NuwanUdara/Digital-Alarm-Clock/Full Product/Report/readme.txt

This is the final project report for our project and written using latex. Overleaf editor was used and the project link is 
https://www.overleaf.com/read/dtgxvjcbbptn
