NuwanUdara/Digital-Alarm-Clock/Microproducts/Audio Ouput/PCB/Read Me.txt

https://oshwlab.com/nuwanudara36/audio-output

PCB done in easyEDA online tool and active project link is provided above. There are 3 pcb files currently.
1. Single layer with 3 jumper connections marked as bottom layer
2. Fully single layer Pcb with low route width
3. Full 2 layer pcb
4. Fully Single layer PCB with Good routings

The altium files are not working properly please use eazyEDA
