NuwanUdara/Digital-Alarm-Clock/Full Product/Report/src/LCD Images/LCD 16.jpg

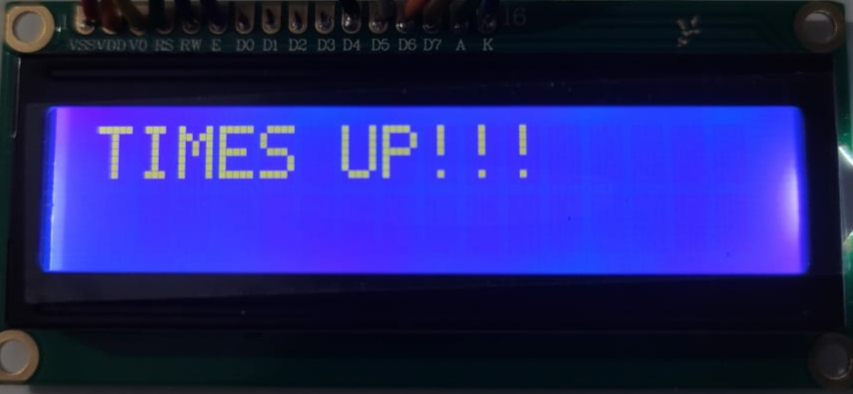
Full Product/Report/src/LCD Images/LCD 16.jpg
