NuwanUdara/Digital-Alarm-Clock/Microproducts/Audio Ouput/PCB/PCB_PCB_Audio Output.png

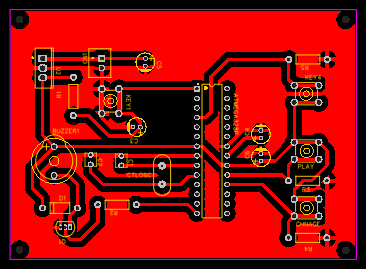
Microproducts/Audio Ouput/PCB/PCB_PCB_Audio Output.png
