NuwanUdara/Digital-Alarm-Clock/Microproducts/Menu Display/Evaluation 2/PCB develop/schemtic/Schematic_Menu-display.png

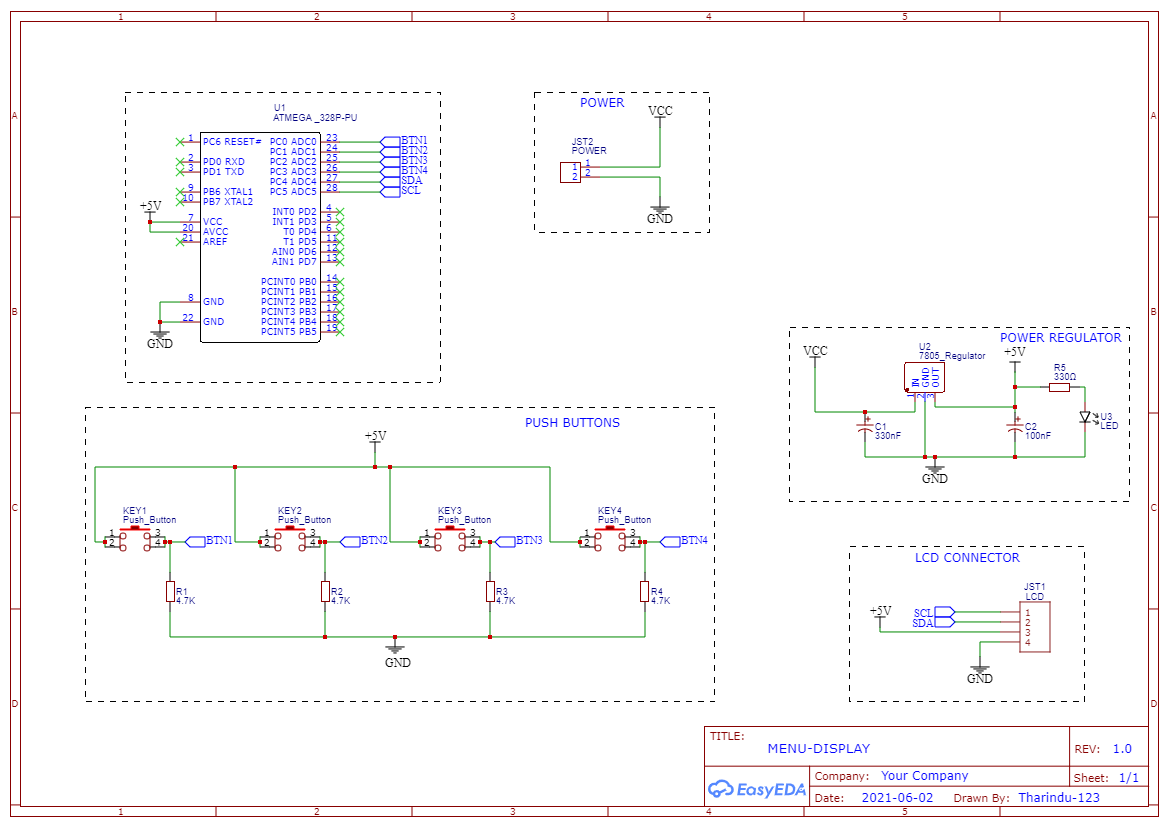
Microproducts/Menu Display/Evaluation 2/PCB develop/schemtic/Schematic_Menu-display.png
