NuwanUdara/Digital-Alarm-Clock/Microproducts/Audio Ouput/Enclosure/Assem6.SLDASM

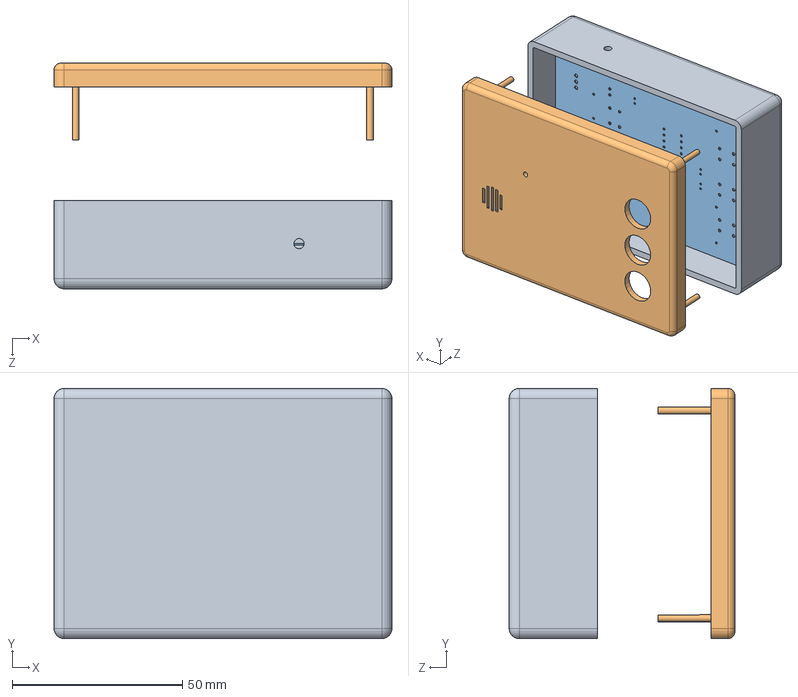
[picture p39: CAD file, 2021-06-05]
Microproducts/Audio Ouput/Enclosure/Assem6.SLDASM
99.2 x 73.4 x 66.3 mm
Part7^PCB_Audio Output.step
Part8^PCB_Audio Output.step. v1SLDPRT
