NuwanUdara/Digital-Alarm-Clock/Microproducts/Menu Display/Evaluation 2/Enclosure/full product.SLDASM

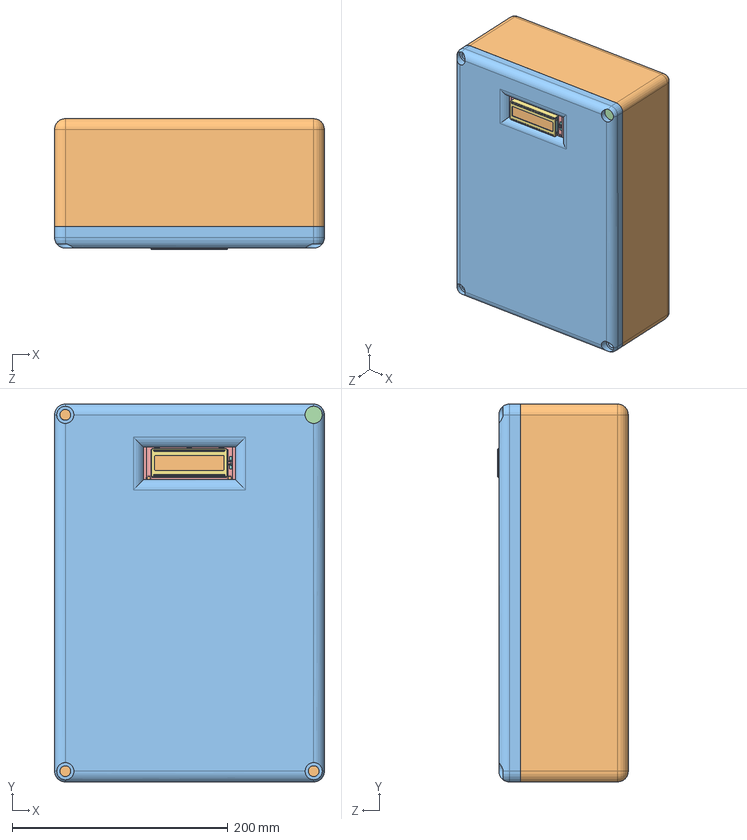
[picture p40: CAD file, 2021-08-10]
Microproducts/Menu Display/Evaluation 2/Enclosure/full product.SLDASM
250.0 x 350.0 x 121.1 mm
OBJ_PCB_Menu-display
back cover
nut
pcbboard
16pin_header__
lcd window
backlight
conductor x 2
liquid crystal grabcad
smt_resistor222 x 6
smt_resistor101 x 2
