NuwanUdara/Digital-Alarm-Clock/Microproducts/Alarm Timing/Enclosure/Enclosure.SLDASM

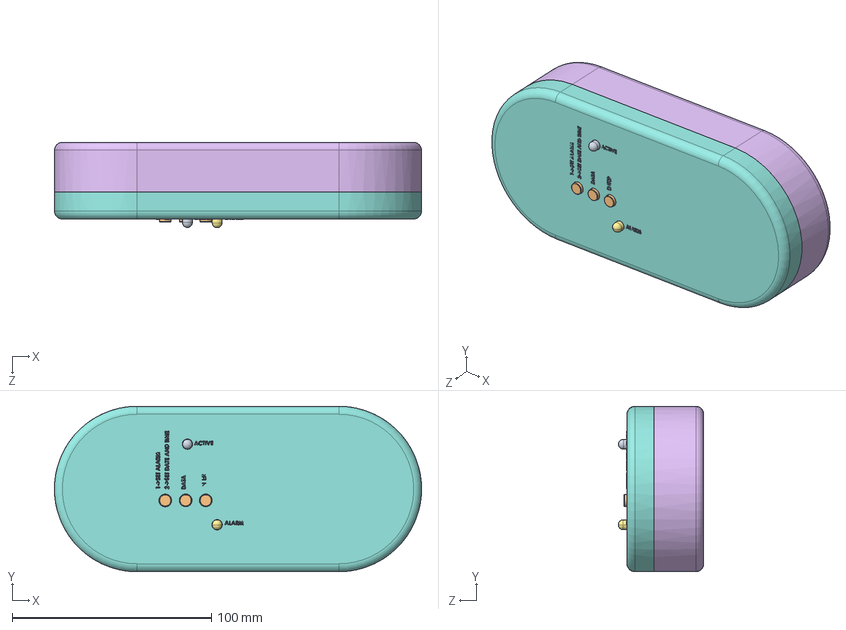
[picture p41: CAD file, 2021-06-02]
Microproducts/Alarm Timing/Enclosure/Enclosure.SLDASM
184.4 x 83.1 x 43.0 mm
Extruded.step
Extruded-0.step x 2
Extruded-1.step x 2
Extruded-2.step x 4
Extruded-3.step x 2
Extruded-4.step x 2
Extruded-5.step x 2
Extruded-6.step x 2
Extruded-7.step x 4
Extruded-8.step x 2
Extruded-9.step x 2
Extruded-10.step x 4
Extruded-11.step x 2
Extruded-12.step x 2
Extruded-13.step
Extruded-14.step
Extruded-15.step x 3
Extruded-16.step x 3
Extruded-17.step
Extruded-18.step
Part1^Enclosure
LED
Part3^Enclosure
Led_Verde
Push Button x 3
