NuwanUdara/Digital-Alarm-Clock/Microproducts/Audio Ouput/Enclosure/Last Build/Assem7.SLDASM

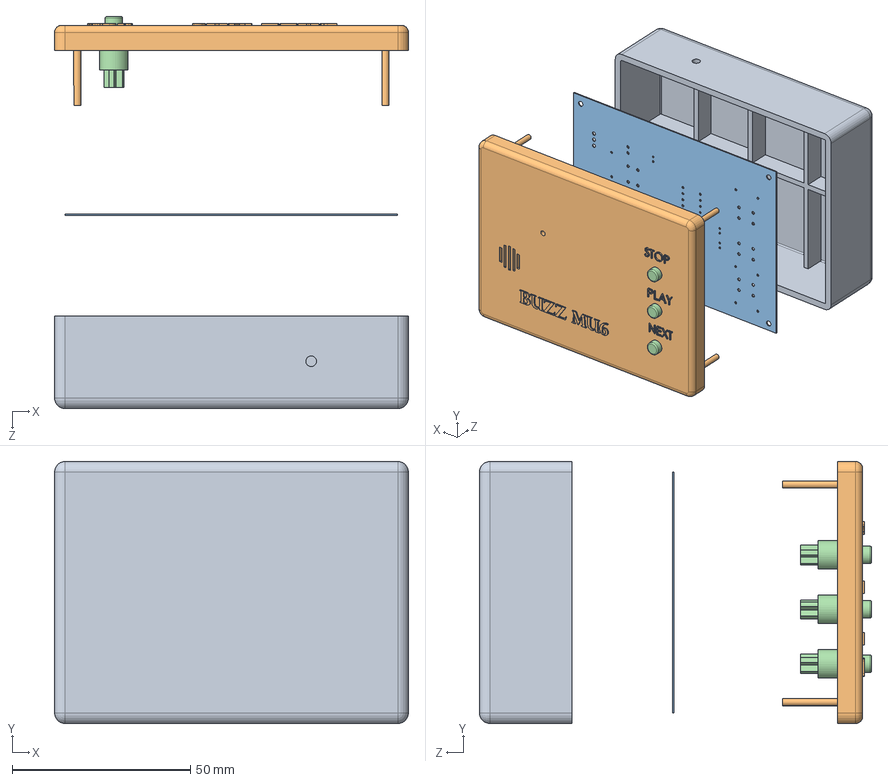
[picture p42: CAD file, 2021-06-07]
Microproducts/Audio Ouput/Enclosure/Last Build/Assem7.SLDASM
99.2 x 73.4 x 109.9 mm
Part7^PCB_Audio Output.step
Part8^PCB_Audio Output.step. v1SLDPRT
Button x 3
