NuwanUdara/Digital-Alarm-Clock/Microproducts/Audio Ouput/Enclosure/PCB_Audio Output.step.SLDASM

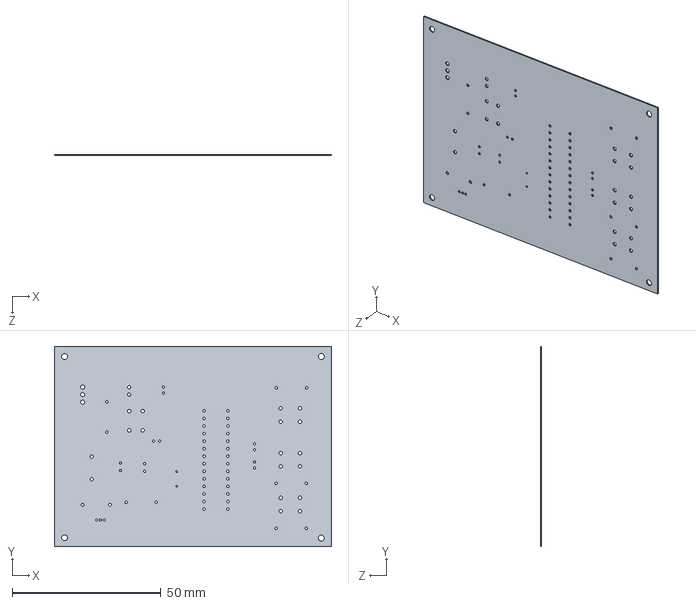
[picture p43: CAD file, 2021-06-05]
Microproducts/Audio Ouput/Enclosure/PCB_Audio Output.step.SLDASM
93.2 x 67.4 x 0.411 mm
