NuwanUdara/Digital-Alarm-Clock/Microproducts/Key Input/Enclosure/led_full.SLDASM

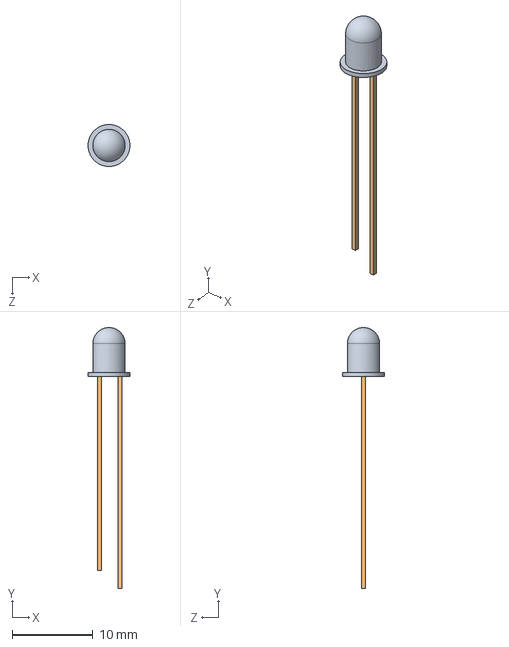
[picture p45: CAD file, 2021-06-04]
Microproducts/Key Input/Enclosure/led_full.SLDASM
5.20 x 32.3 x 5.19 mm
led2
led
