NuwanUdara/Digital-Alarm-Clock/Microproducts/Menu Display/Evaluation 2/Enclosure/parts/LCD.SLDASM

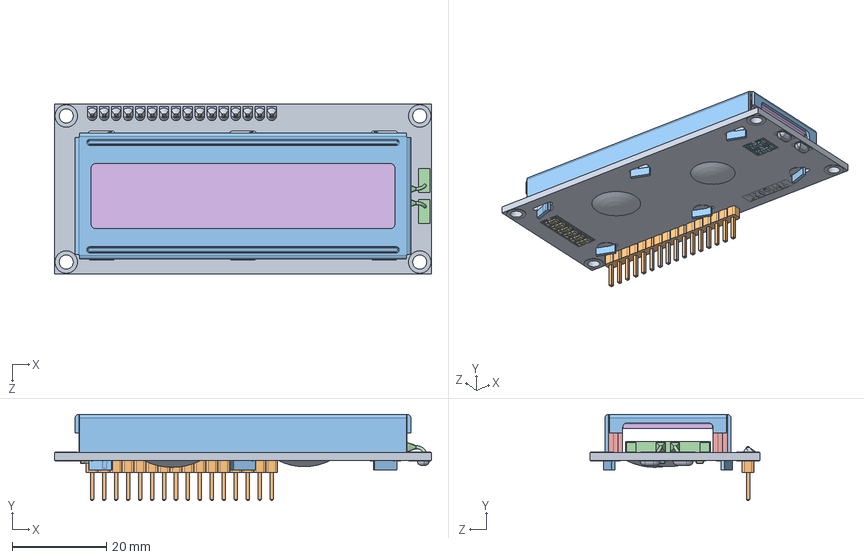
[picture p46: CAD file, 2021-06-05]
Microproducts/Menu Display/Evaluation 2/Enclosure/parts/LCD.SLDASM
80.0 x 18.3 x 36.0 mm
pcbboard
16pin_header__
lcd window
backlight
conductor x 2
liquid crystal grabcad
smt_resistor222 x 6
smt_resistor101 x 2
