NuwanUdara/Digital-Alarm-Clock/Full Product/Enclosure of final product and components/cct.SLDASM

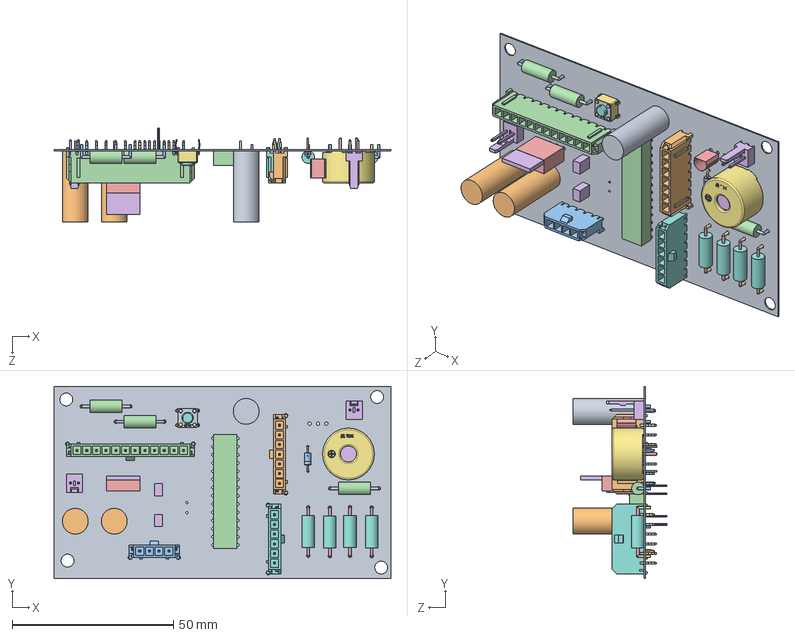
[picture p47: CAD file, 2021-08-11]
Full Product/Enclosure of final product and components/cct.SLDASM
104.4 x 59.6 x 29.0 mm
6620xx11122_PIN.step x 4
66200411122-0.step
Extruded.step
Extruded-1.step
Extruded-2.step
Body.step
button.step
cover.step
leads.step
circle.step
TE_Connectivity.step
Cylinder.step x 4
Sphere.step x 8
Cylinder-3.step x 8
Cylinder-4.step x 4
Cylinder-5.step x 3
Sphere-6.step x 6
Cylinder-7.step x 6
Cylinder-8.step x 3
Extruded-9.step
6620xx11122_PIN-10.step x 6
66200611122-11.step
6620xx11122_PIN-12.step x 7
66200711122-13.step
6620xx11122_PIN-14.step x 12
66201211122-15.step
1.step
2.step
3.step
TDK_Logo.step
1-16.step
2-17.step
3-18.step
4.step
Extruded-19.step x 4
Extruded-20.step x 2
Cylinder-21.step
Cylinder-22.step
Cylinder-23.step
Cylinder-24.step x 2
Cylinder-25.step x 2
Cylinder-26.step x 2
