NuwanUdara/Digital-Alarm-Clock/Full Product/Enclosure of final product and components/E-Stop_Assembled.SLDASM

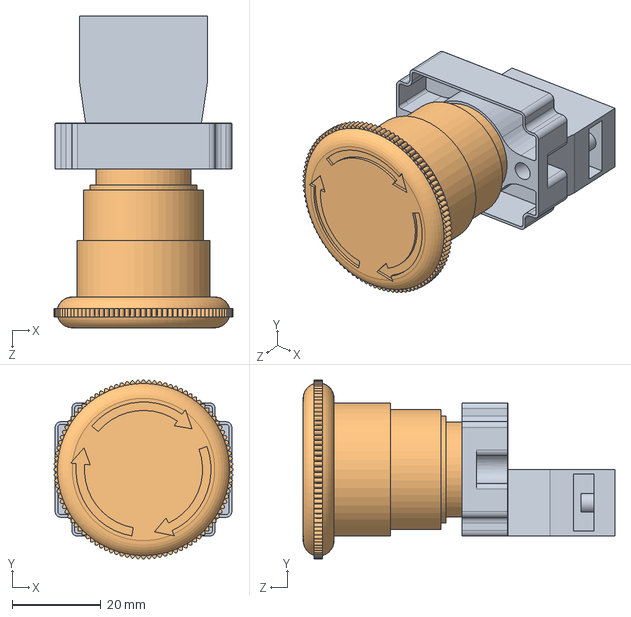
[picture p48: CAD file, 2021-08-10]
Full Product/Enclosure of final product and components/E-Stop_Assembled.SLDASM
40.4 x 40.4 x 70.4 mm
E-Stop Base^E-Stop_Assembled.stp
E-Stop Button^E-Stop_Assembled.stp
