NuwanUdara/Digital-Alarm-Clock/Full Product/Enclosure of final product and components/Battery.SLDPRT

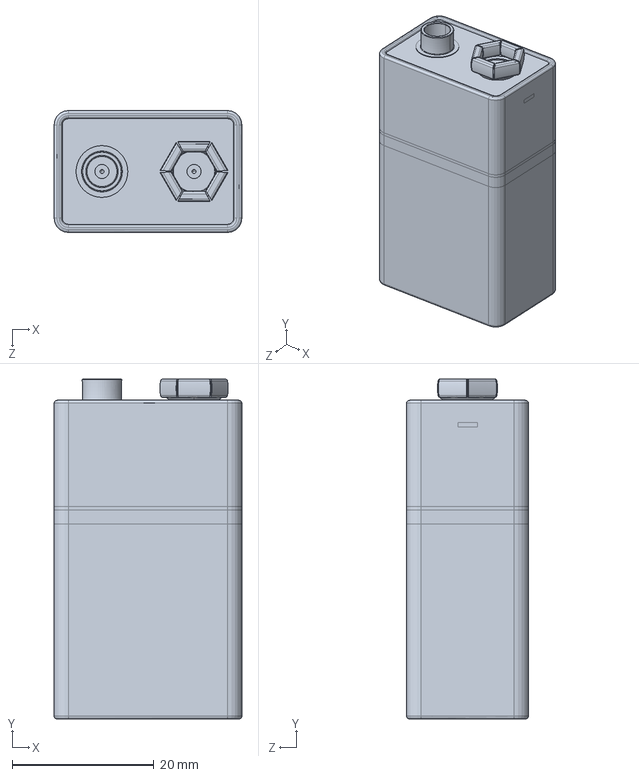
[picture p49: CAD file, 2021-08-11]
Full Product/Enclosure of final product and components/Battery.SLDPRT
26.5 x 48.0 x 17.2 mm
