NuwanUdara/Digital-Alarm-Clock/Microproducts/Alarm Timing/Enclosure/PCB.step

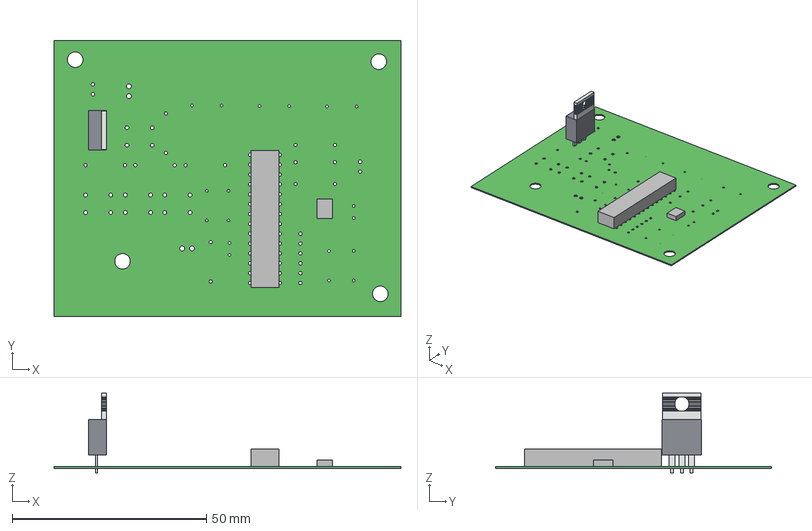
[picture p50: CAD file, 2021-06-02]
Microproducts/Alarm Timing/Enclosure/PCB.step
89.4 x 71.1 x 20.5 mm
Extruded x 43
