NuwanUdara/Digital-Alarm-Clock/Microproducts/Audio Ouput/Enclosure/Last Build/Button.SLDPRT

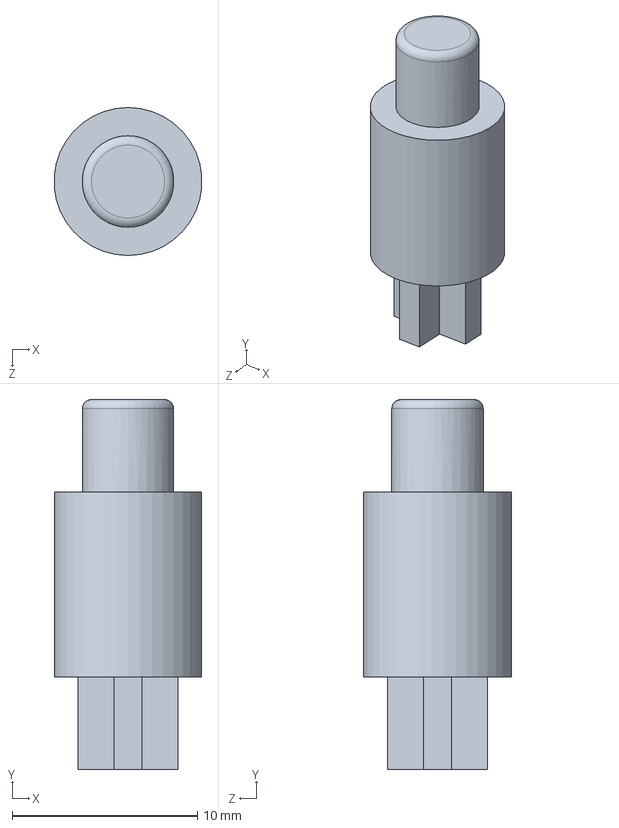
[picture p51: CAD file, 2021-06-07]
Microproducts/Audio Ouput/Enclosure/Last Build/Button.SLDPRT
7.97 x 20.0 x 8.00 mm
