NuwanUdara/Digital-Alarm-Clock/Microproducts/Key Input/Enclosure/keypad.SLDPRT

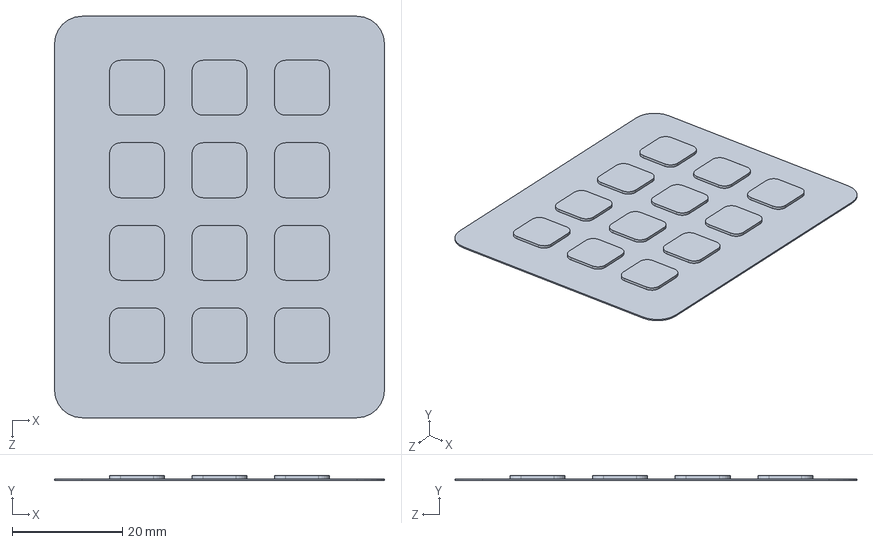
[picture p52: CAD file, 2021-06-04]
Microproducts/Key Input/Enclosure/keypad.SLDPRT
60.0 x 0.9 x 73.0 mm
