NuwanUdara/Digital-Alarm-Clock/Microproducts/Menu Display/Evaluation 2/Enclosure/parts/OBJ_PCB_Menu-display.SLDPRT

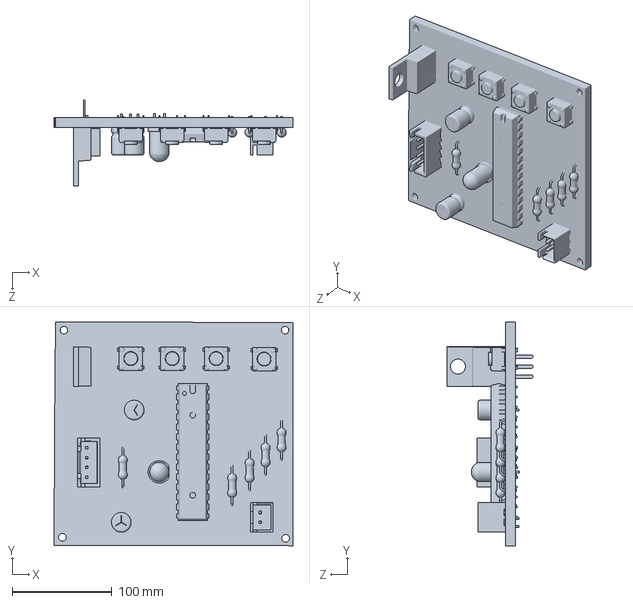
[picture p53: CAD file, 2021-06-05]
Microproducts/Menu Display/Evaluation 2/Enclosure/parts/OBJ_PCB_Menu-display.SLDPRT
239.3 x 223.8 x 86.2 mm
