NuwanUdara/Digital-Alarm-Clock/Full Product/Enclosure of final product and components/KeyPad_3x4_w_pcb.step

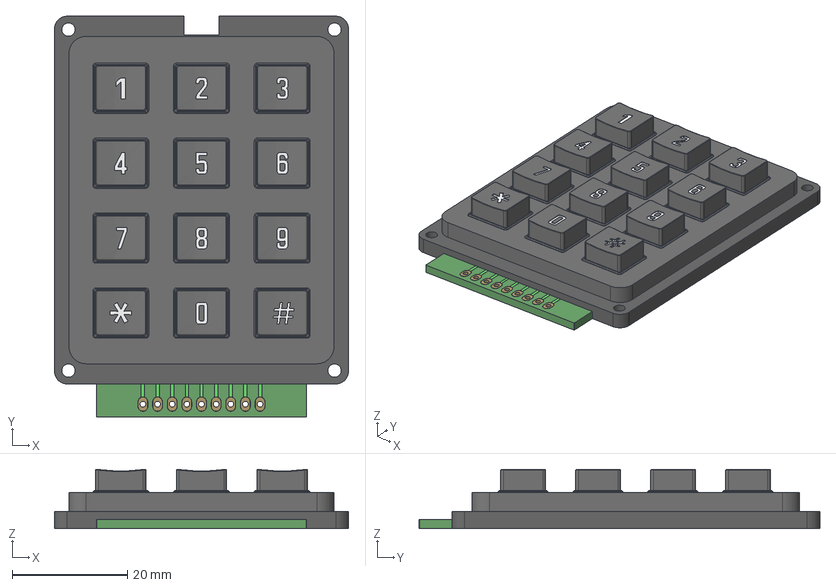
[picture p54: CAD file, 2021-08-11]
Full Product/Enclosure of final product and components/KeyPad_3x4_w_pcb.step
51.0 x 69.5 x 10.3 mm
Body_top
KeyPad
Body_bottom
PCB_pads
PCB
PCBtracks
KeyPad_collor
