NuwanUdara/Digital-Alarm-Clock/Microproducts/Key Input/Enclosure/led2.SLDPRT

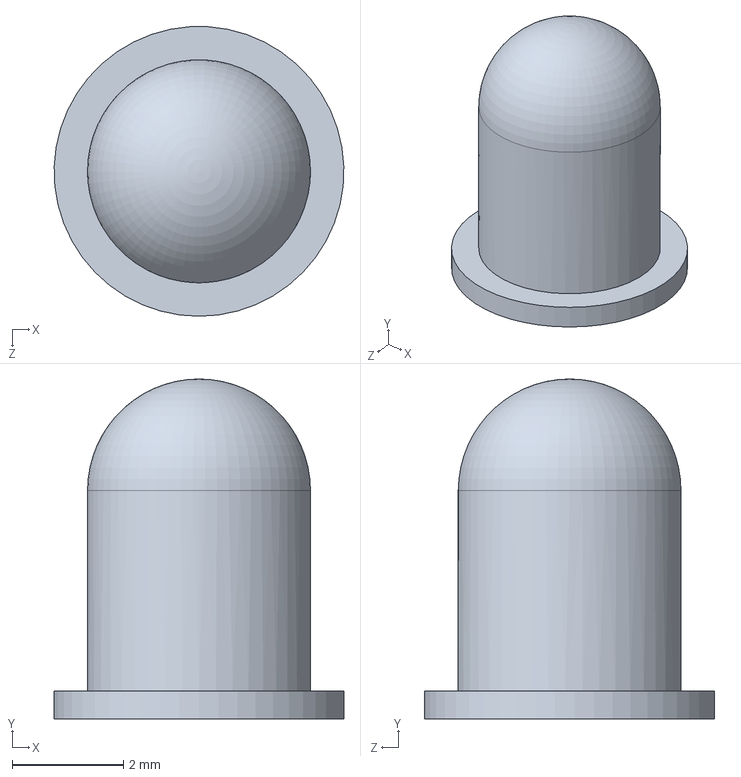
[picture p55: CAD file, 2021-06-04]
Microproducts/Key Input/Enclosure/led2.SLDPRT
5.20 x 6.10 x 5.19 mm
