NuwanUdara/Digital-Alarm-Clock/Microproducts/Menu Display/Evaluation 2/Enclosure/parts/face.SLDPRT

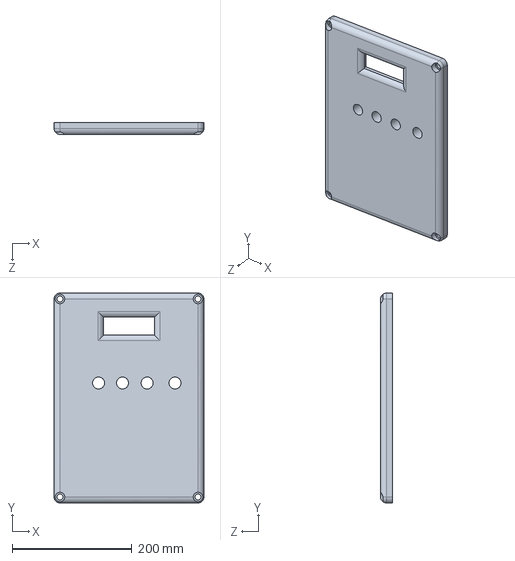
[picture p56: CAD file, 2021-06-05]
Microproducts/Menu Display/Evaluation 2/Enclosure/parts/face.SLDPRT
250.0 x 350.0 x 20.0 mm
