NuwanUdara/Digital-Alarm-Clock/Microproducts/Alarm Timing/Enclosure/Led_Verde.SLDPRT

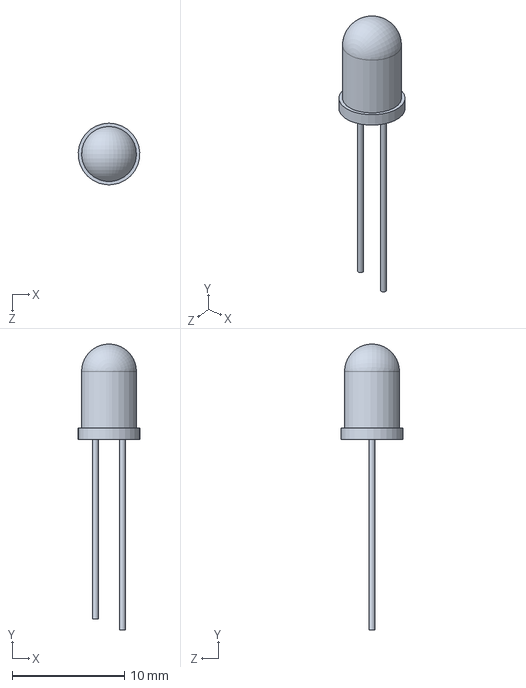
[picture p57: CAD file, 2021-06-02]
Microproducts/Alarm Timing/Enclosure/Led_Verde.SLDPRT
5.49 x 25.5 x 5.50 mm
