NuwanUdara/Digital-Alarm-Clock/Microproducts/Key Input/Enclosure/Key_Input.step

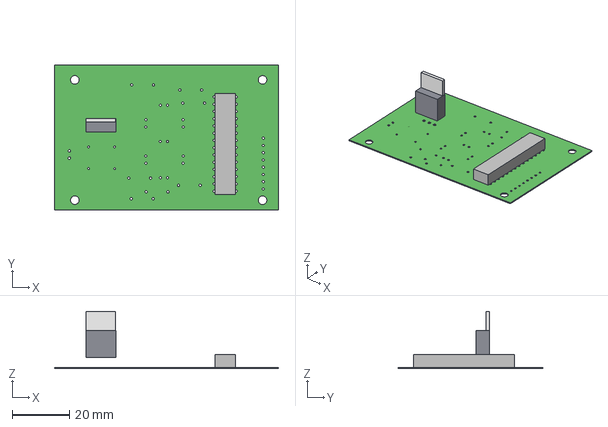
[picture p58: CAD file, 2021-06-04]
Microproducts/Key Input/Enclosure/Key_Input.step
78.5 x 50.8 x 20.1 mm
Extruded x 3
