NuwanUdara/Digital-Alarm-Clock/Microproducts/Menu Display/Evaluation 2/Enclosure/parts/back cover.SLDPRT

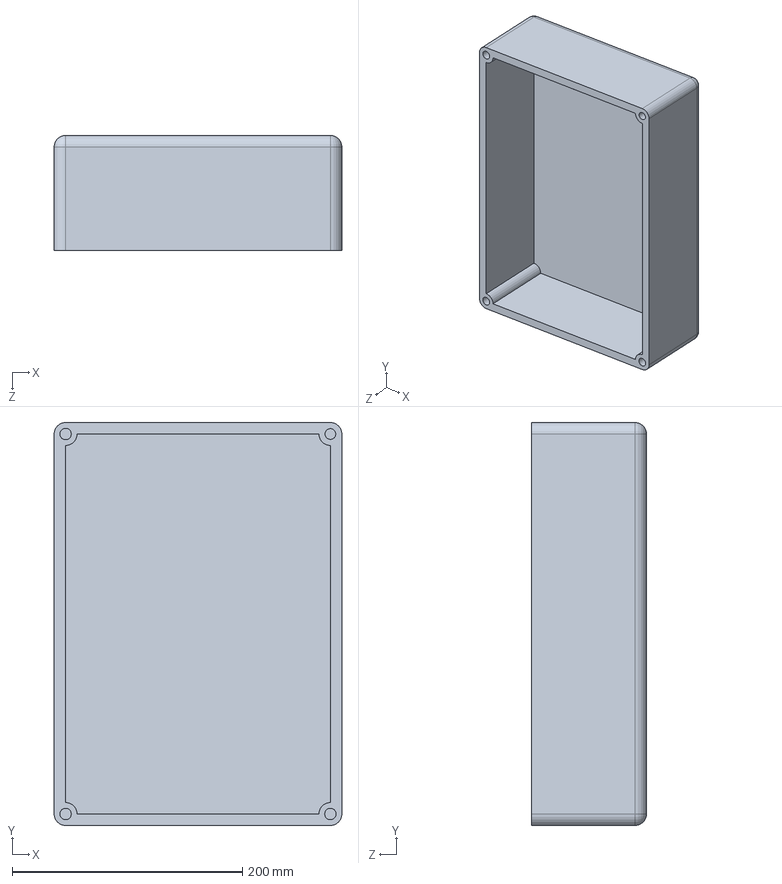
[picture p59: CAD file, 2021-06-05]
Microproducts/Menu Display/Evaluation 2/Enclosure/parts/back cover.SLDPRT
250.0 x 350.0 x 100.0 mm
