NuwanUdara/Digital-Alarm-Clock/Full Product/Enclosure of final product and components/smt_resistor101.sldprt

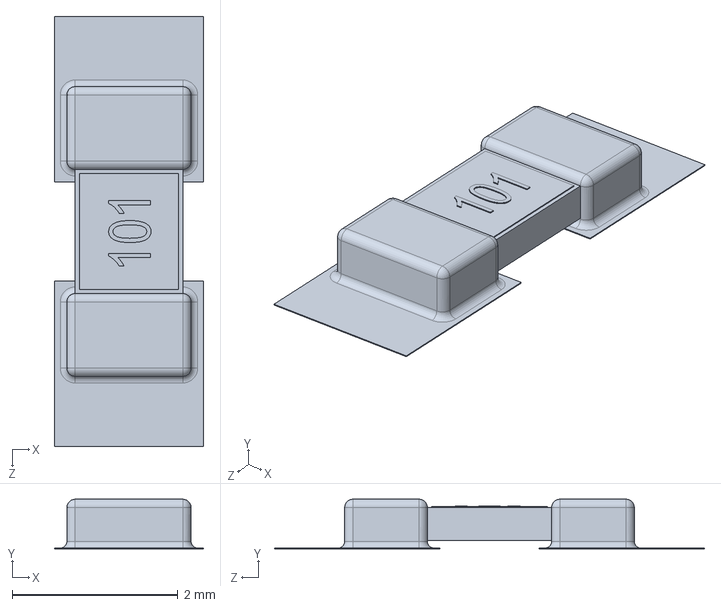
[picture p60: CAD file, 2021-08-11]
Full Product/Enclosure of final product and components/smt_resistor101.sldprt
1.80 x 0.6 x 5.20 mm
