NuwanUdara/Digital-Alarm-Clock/Microproducts/Alarm Timing/Enclosure/Push Button.SLDPRT

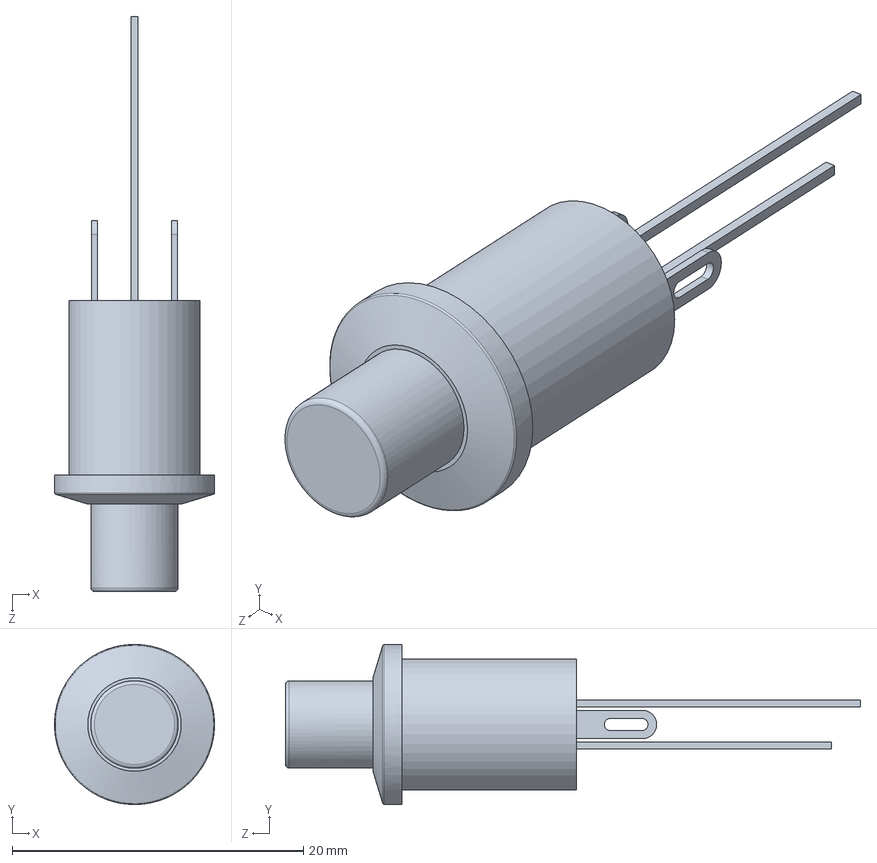
[picture p61: CAD file, 2021-06-02]
Microproducts/Alarm Timing/Enclosure/Push Button.SLDPRT
11.0 x 11.0 x 39.5 mm
