NuwanUdara/Digital-Alarm-Clock/Full Product/Enclosure of final product and components/pcbboard.SLDPRT

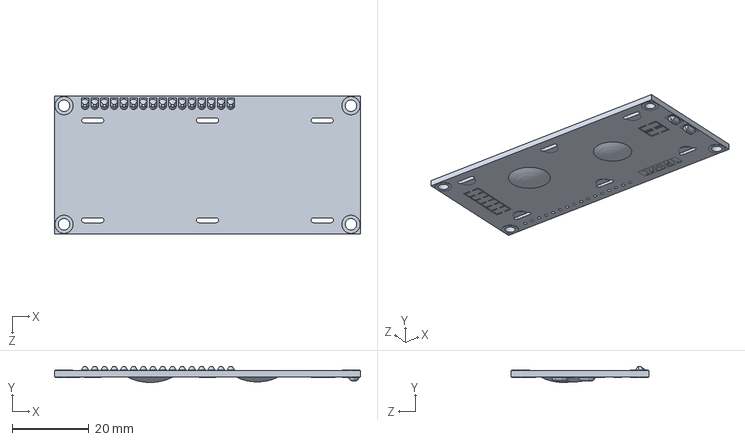
[picture p62: CAD file, 2021-08-11]
Full Product/Enclosure of final product and components/pcbboard.SLDPRT
80.0 x 4.19 x 36.0 mm
