NuwanUdara/Digital-Alarm-Clock/Microproducts/Alarm Timing/Enclosure/LED.SLDPRT

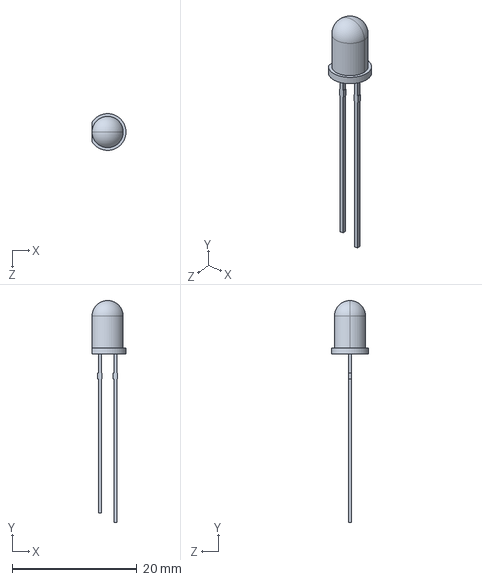
[picture p63: CAD file, 2021-06-02]
Microproducts/Alarm Timing/Enclosure/LED.SLDPRT
5.44 x 35.6 x 5.90 mm
