NuwanUdara/Digital-Alarm-Clock/Microproducts/Key Input/Enclosure/led.SLDPRT

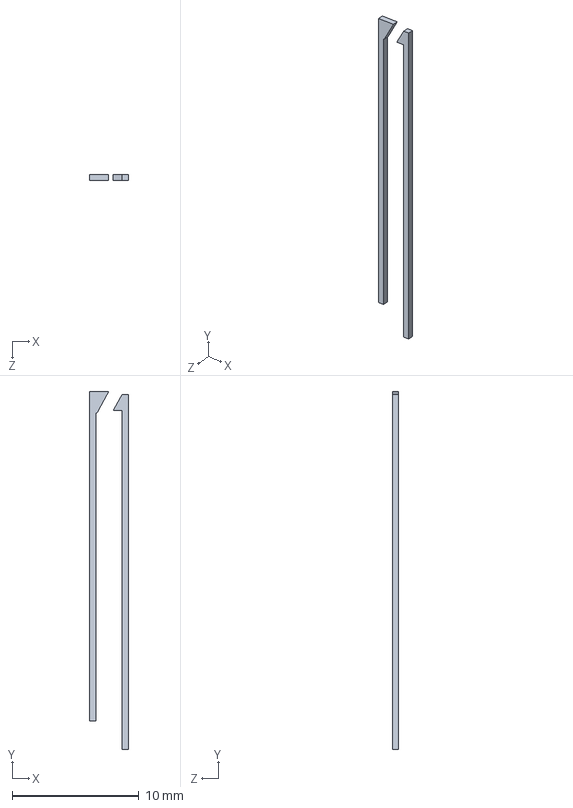
[picture p64: CAD file, 2021-06-04]
Microproducts/Key Input/Enclosure/led.SLDPRT
3.04 x 28.3 x 0.5 mm
