NuwanUdara/Digital-Alarm-Clock/Full Product/Enclosure of final product and components/9V Battery Holder.SLDPRT

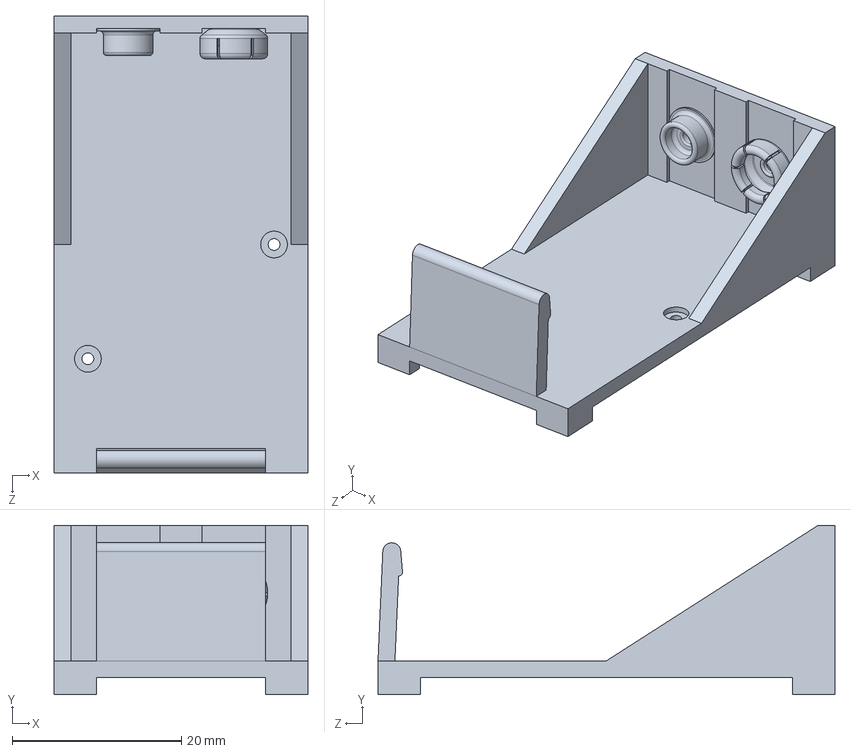
[picture p65: CAD file, 2021-08-11]
Full Product/Enclosure of final product and components/9V Battery Holder.SLDPRT
30.0 x 20.0 x 54.0 mm
