NuwanUdara/Digital-Alarm-Clock/Microproducts/Audio Ouput/Enclosure/Last Build/Part7^PCB_Audio Output.step.SLDPRT

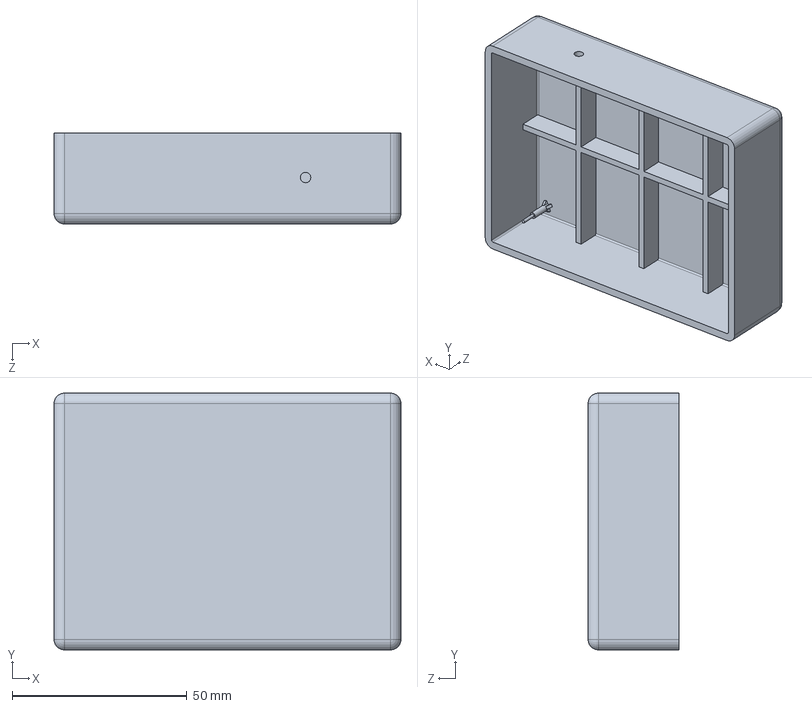
[picture p66: CAD file, 2021-06-05]
Microproducts/Audio Ouput/Enclosure/Last Build/Part7^PCB_Audio Output.step.SLDPRT
99.2 x 73.4 x 26.0 mm
