NuwanUdara/Digital-Alarm-Clock/Microproducts/Key Input/Enclosure/switch.SLDPRT

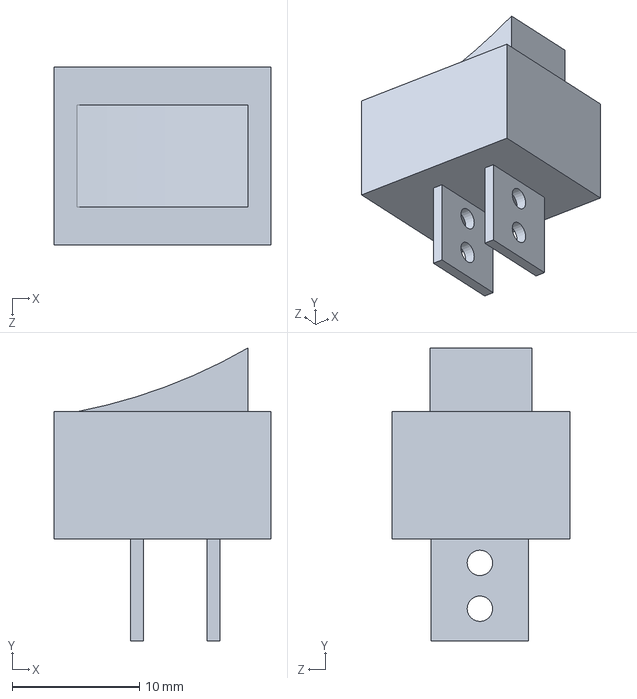
[picture p67: CAD file, 2021-06-04]
Microproducts/Key Input/Enclosure/switch.SLDPRT
17.0 x 23.0 x 14.0 mm
