NuwanUdara/Digital-Alarm-Clock/Full Product/Enclosure of final product and components/body.SLDPRT

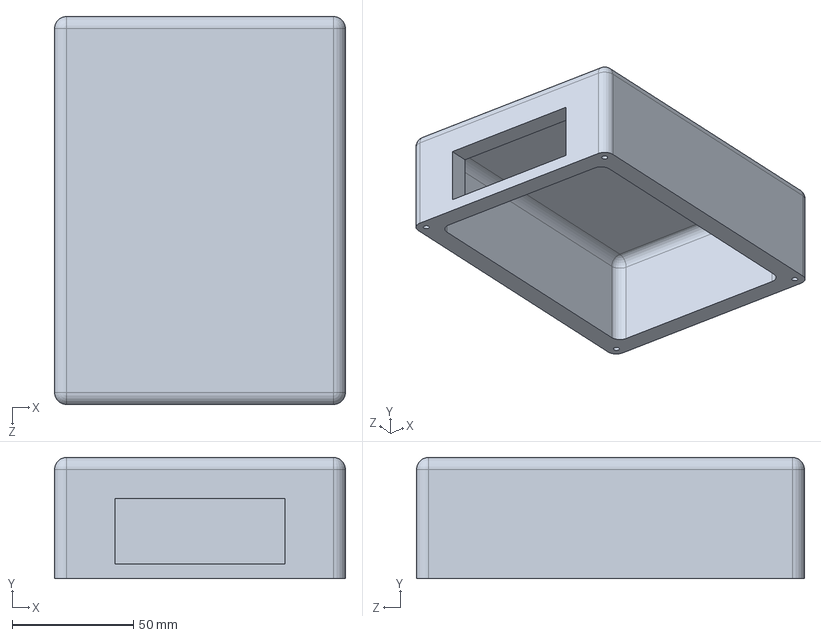
[picture p68: CAD file, 2021-08-11]
Full Product/Enclosure of final product and components/body.SLDPRT
120.0 x 50.0 x 160.0 mm
