NuwanUdara/Digital-Alarm-Clock/Full Product/Enclosure of final product and components/backlight.SLDPRT

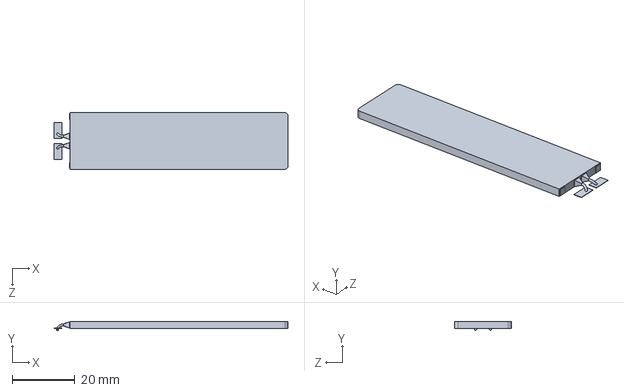
[picture p69: CAD file, 2021-08-11]
Full Product/Enclosure of final product and components/backlight.SLDPRT
74.4 x 2.98 x 18.0 mm
