NuwanUdara/Digital-Alarm-Clock/Full Product/Enclosure of final product and components/conductor.SLDPRT

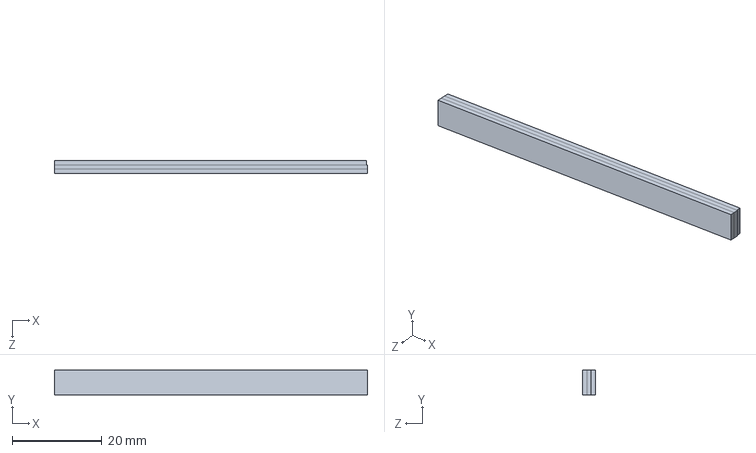
[picture p70: CAD file, 2021-08-11]
Full Product/Enclosure of final product and components/conductor.SLDPRT
69.7 x 5.50 x 3.00 mm
