NuwanUdara/Digital-Alarm-Clock/Full Product/Enclosure of final product and components/smt_resistor222.sldprt

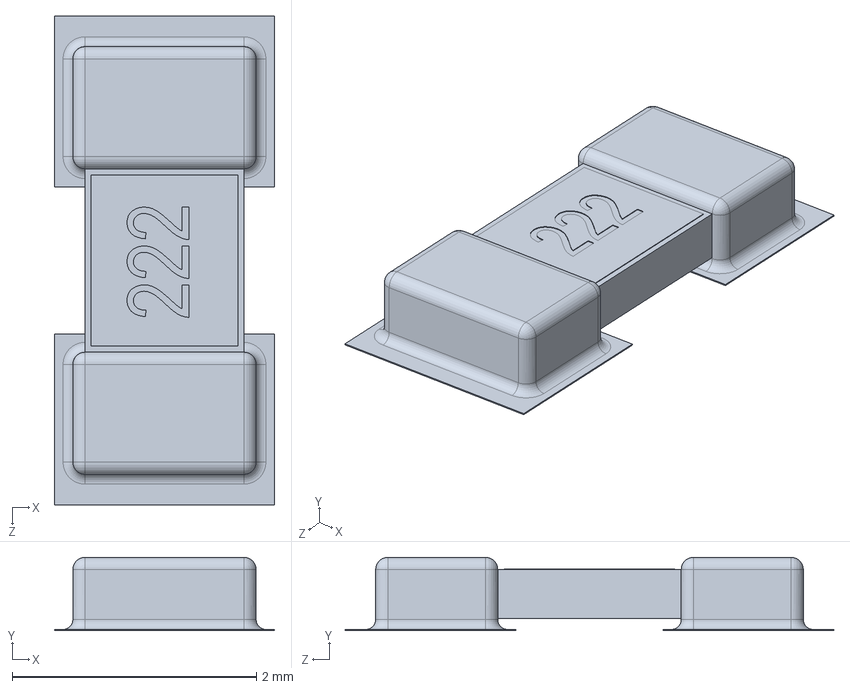
[picture p71: CAD file, 2021-08-11]
Full Product/Enclosure of final product and components/smt_resistor222.sldprt
1.80 x 0.6 x 4.00 mm
