NuwanUdara/Digital-Alarm-Clock/Full Product/Enclosure of final product and components/lcd window.SLDPRT

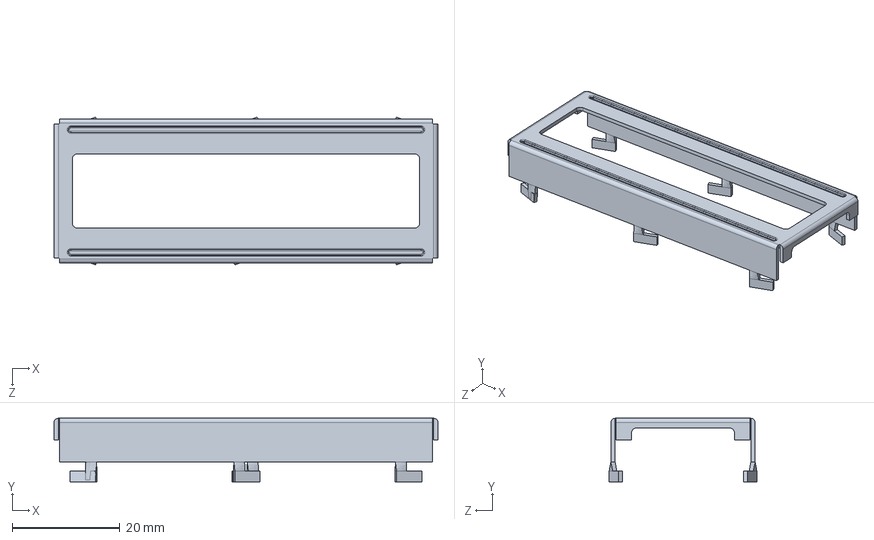
[picture p72: CAD file, 2021-08-11]
Full Product/Enclosure of final product and components/lcd window.SLDPRT
71.3 x 11.8 x 27.4 mm
