NuwanUdara/Digital-Alarm-Clock/Full Product/Enclosure of final product and components/16pin_header__.sldprt

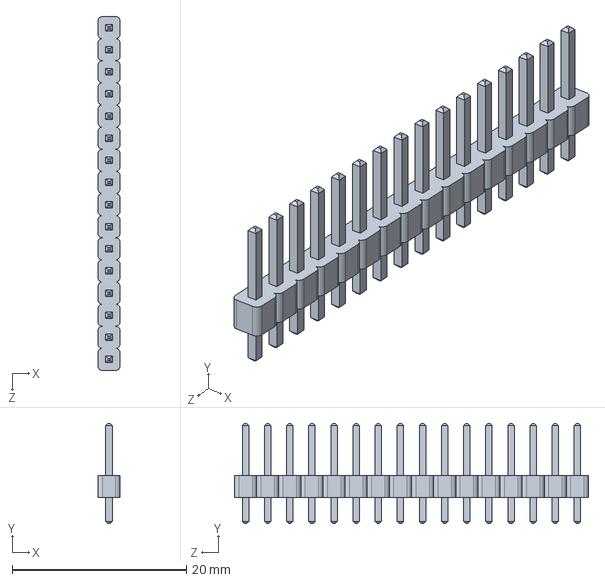
[picture p73: CAD file, 2021-08-11]
Full Product/Enclosure of final product and components/16pin_header__.sldprt
2.54 x 11.5 x 40.6 mm
