NuwanUdara/Digital-Alarm-Clock/Full Product/Enclosure of final product and components/pin.SLDPRT

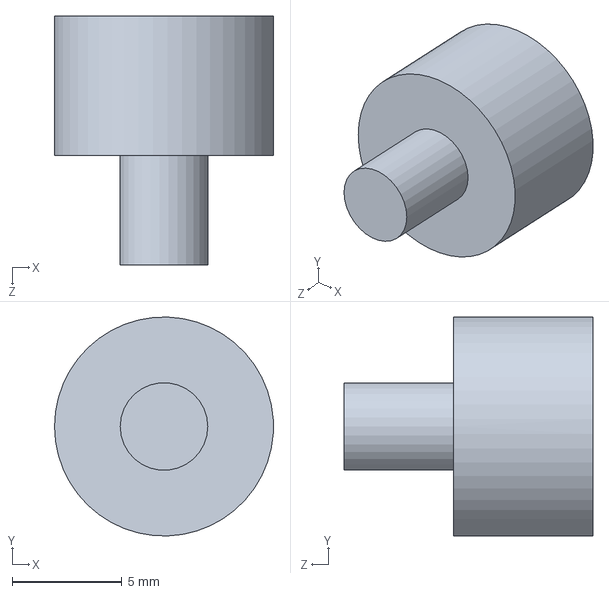
[picture p74: CAD file, 2021-08-11]
Full Product/Enclosure of final product and components/pin.SLDPRT
10.0 x 9.99 x 11.4 mm
