NuwanUdara/Digital-Alarm-Clock/Full Product/Enclosure of final product and components/base.SLDPRT

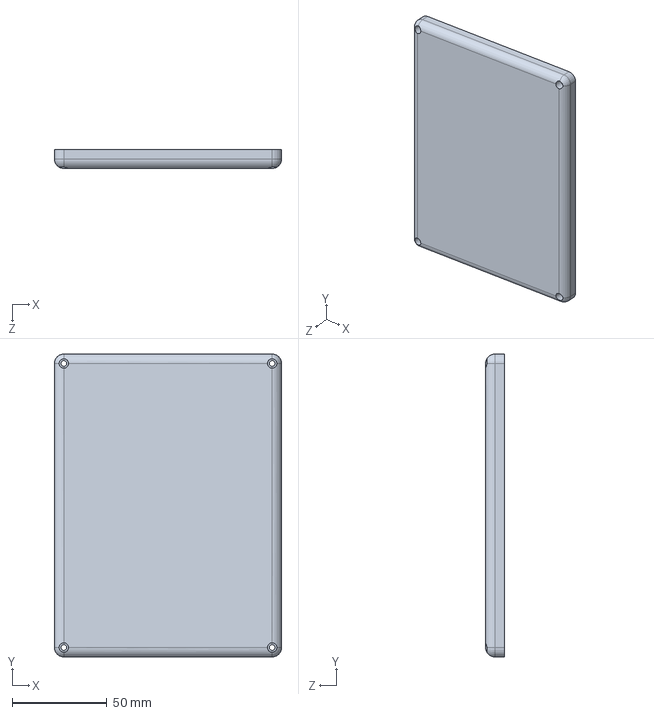
[picture p75: CAD file, 2021-08-11]
Full Product/Enclosure of final product and components/base.SLDPRT
120.0 x 160.0 x 10.0 mm
