NuwanUdara/Digital-Alarm-Clock/Full Product/Enclosure of final product and components/pin1 lcd.SLDPRT

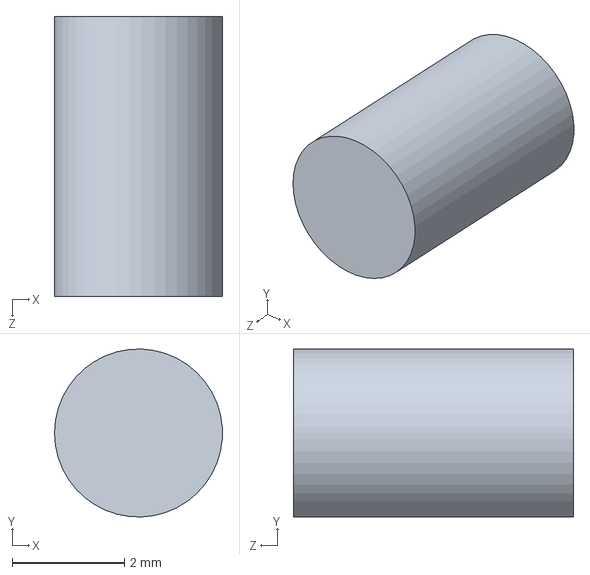
[picture p76: CAD file, 2021-08-10]
Full Product/Enclosure of final product and components/pin1 lcd.SLDPRT
3.00 x 3.00 x 5.00 mm
