NuwanUdara/Digital-Alarm-Clock/Full Product/Enclosure of final product and components/leg.SLDPRT

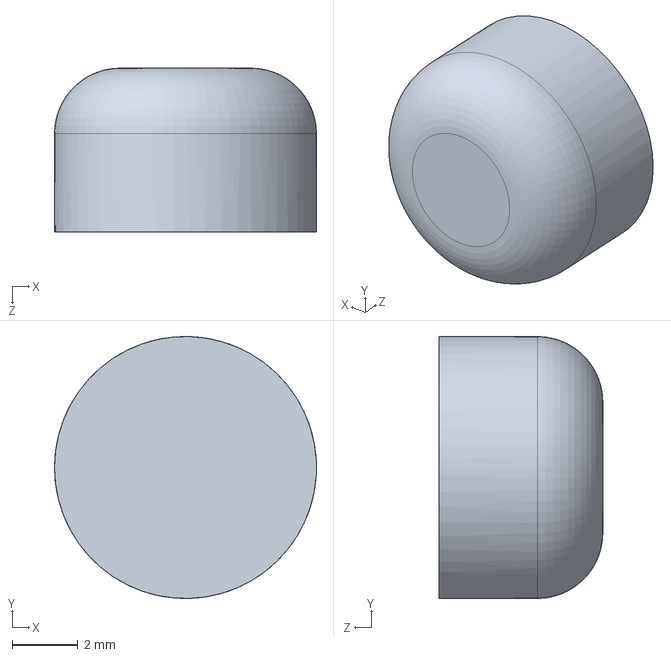
[picture p77: CAD file, 2021-08-10]
Full Product/Enclosure of final product and components/leg.SLDPRT
8.00 x 8.00 x 5.00 mm
