NuwanUdara/Digital-Alarm-Clock/Full Product/Enclosure of final product and components/Emergency Stop Button.SLDPRT

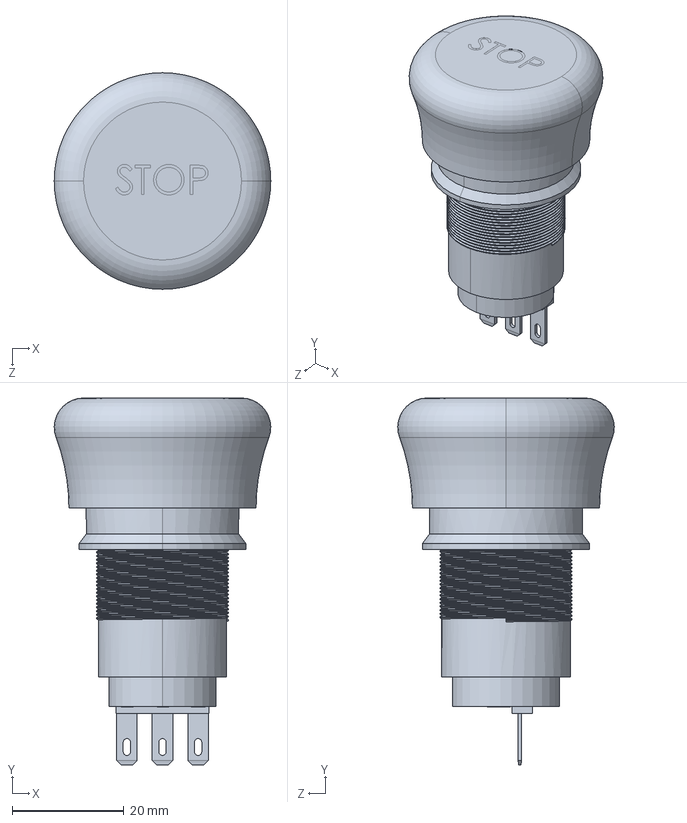
[picture p78: CAD file, 2021-08-10]
Full Product/Enclosure of final product and components/Emergency Stop Button.SLDPRT
38.7 x 65.6 x 38.7 mm
