NuwanUdara/Digital-Alarm-Clock/Full Product/Enclosure of final product and components/cover.SLDPRT

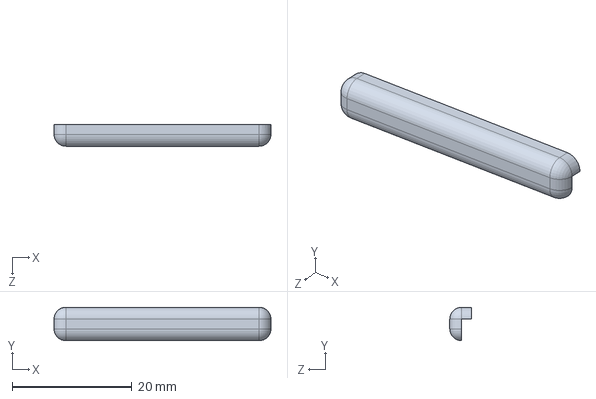
[picture p79: CAD file, 2021-08-10]
Full Product/Enclosure of final product and components/cover.SLDPRT
36.3 x 5.60 x 3.60 mm
