NuwanUdara/Digital-Alarm-Clock/(list of files, cad)

Other CAD files:
Microproducts/Audio Ouput/Enclosure/Assem5.SLDASM
Full Product/Enclosure of final product and components/LCD.SLDASM
Microproducts/Audio Ouput/Enclosure/Last Build/PCB_Audio Output.step
Microproducts/Audio Ouput/Enclosure/Last Build/Part8^PCB_Audio Output.step. v1SLDPRT.SLDPRT
Microproducts/Audio Ouput/Enclosure/Part8^PCB_Audio Output.step. v1SLDPRT.SLDPRT
Microproducts/Audio Ouput/Enclosure/Last Build/Open CASCADE STEP translator 6.8 1.1.1.step.SLDPRT
Full Product/Enclosure of final product and components/Alarm_Clock.step
Full Product/Enclosure of final product and components/KeyPad_3x4_w_pcb.SLDASM
Full Product/Enclosure of final product and components/STP310400160.SLDPRT
Full Product/Enclosure of final product and components/liquid crystal grabcad.SLDPRT
Microproducts/Key Input/Enclosure/Key_Input.SLDASM
Microproducts/Menu Display/Evaluation 2/Enclosure/parts/nut.SLDPRT
