NuwanUdara/Digital-Alarm-Clock/Full Product/Report/src/step.pdf

### Clock

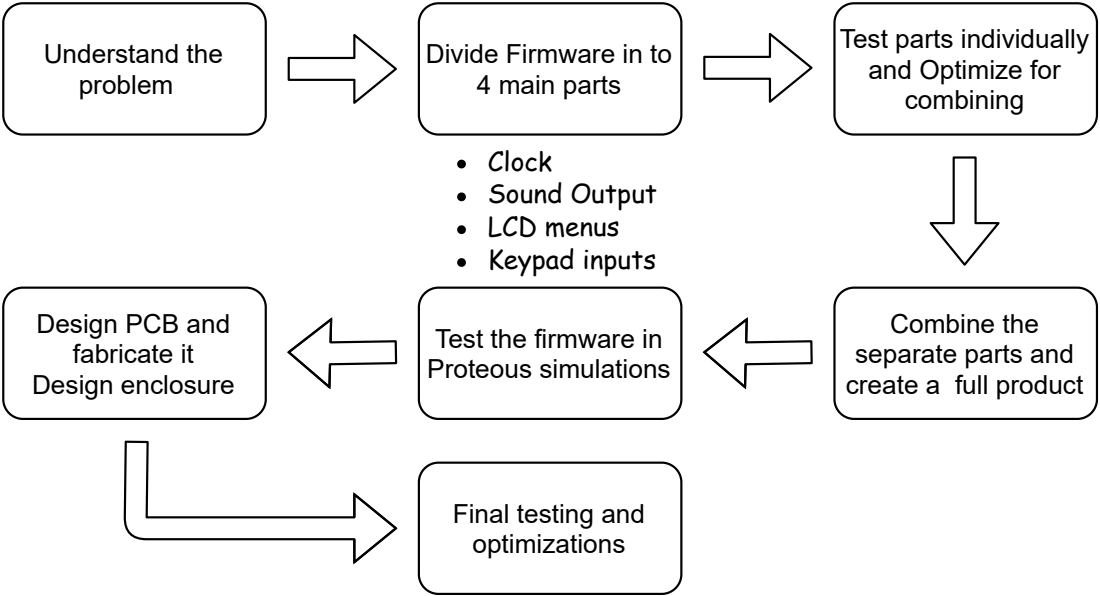
[picture p80: page 1]
Understand the problem; Sound Output LCD menus Keypad inputs

Test parts individually
and Optimize for
combining

Divide Firmware in to
4 main parts

Design PCB and
fabricate it
Design enclosure

Test the firmware in
Proteous simulations

Combine the
separate parts and
create a full product

Final testing and
optimizations
