NuwanUdara/Digital-Alarm-Clock/Microproducts/Audio Ouput/PCB/Schematic_Audio Output.pdf

## Button Input Circuit

Voltage regulator | Power Connector

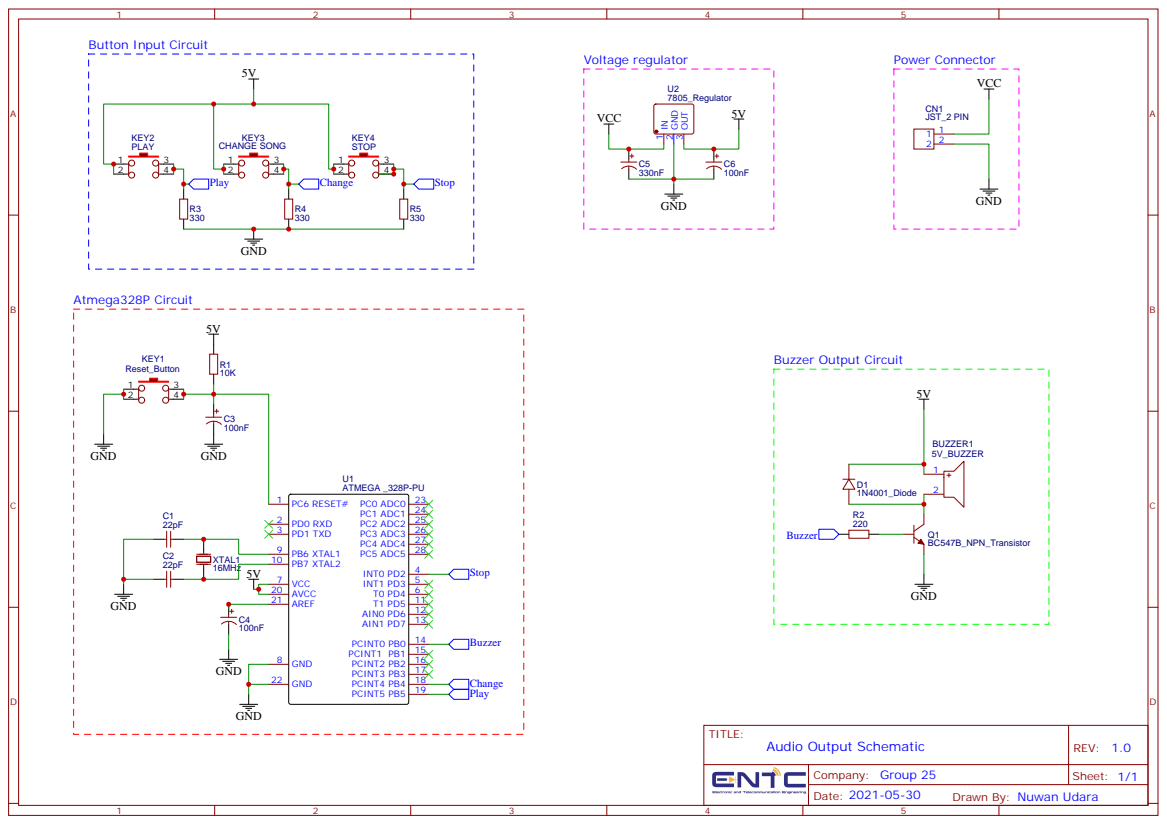
[picture p81: page 1]

Drawn By: Nuwan Udara
