NuwanUdara/Digital-Alarm-Clock/Full Product/Report/src/Appendix/Alarm_Clock.pdf

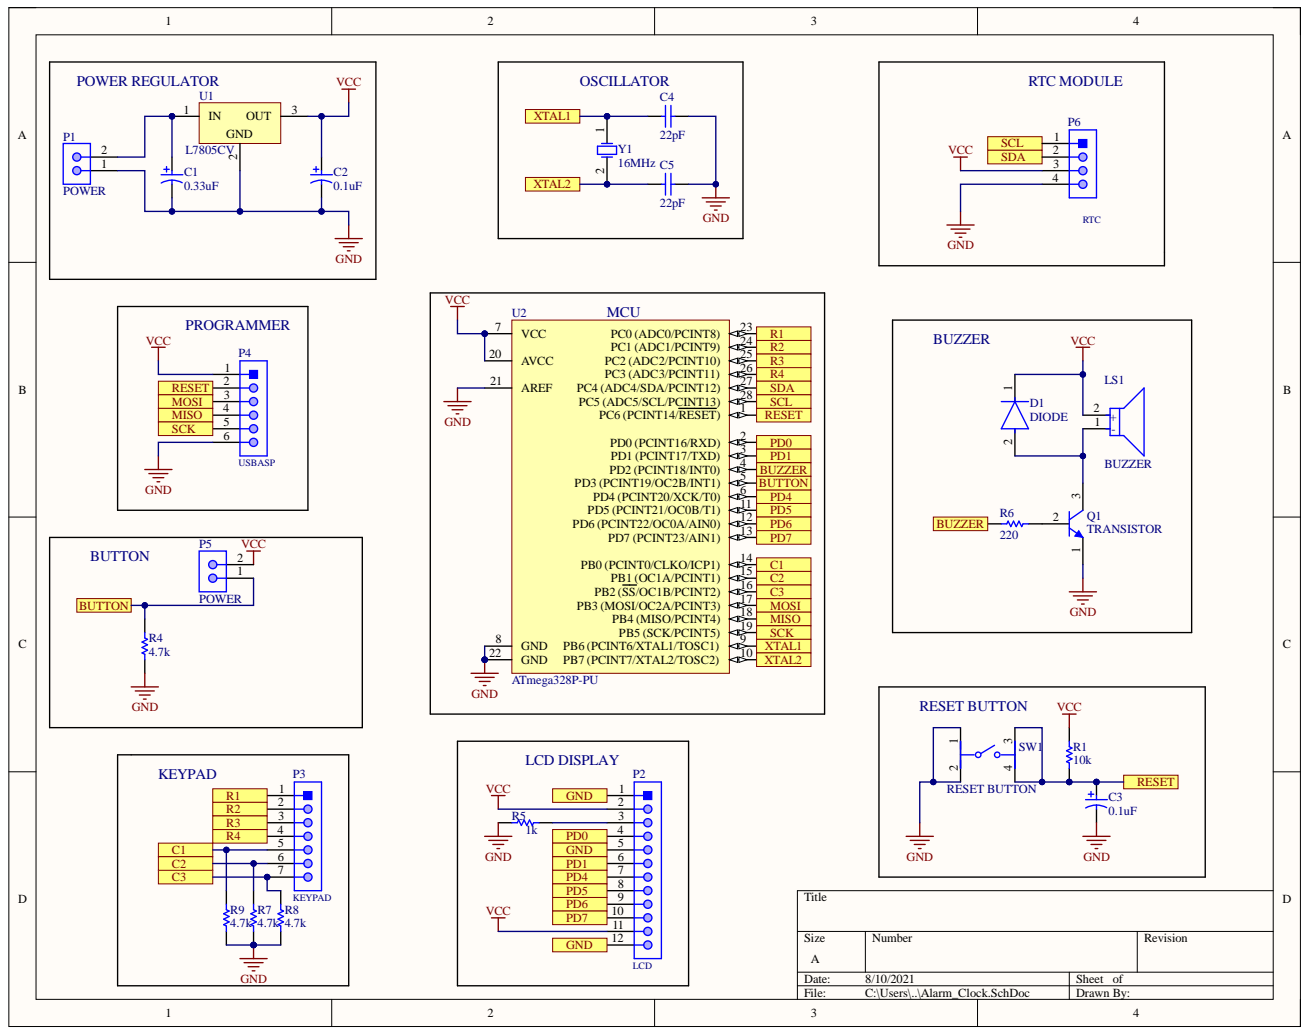
[picture p82: page 1]

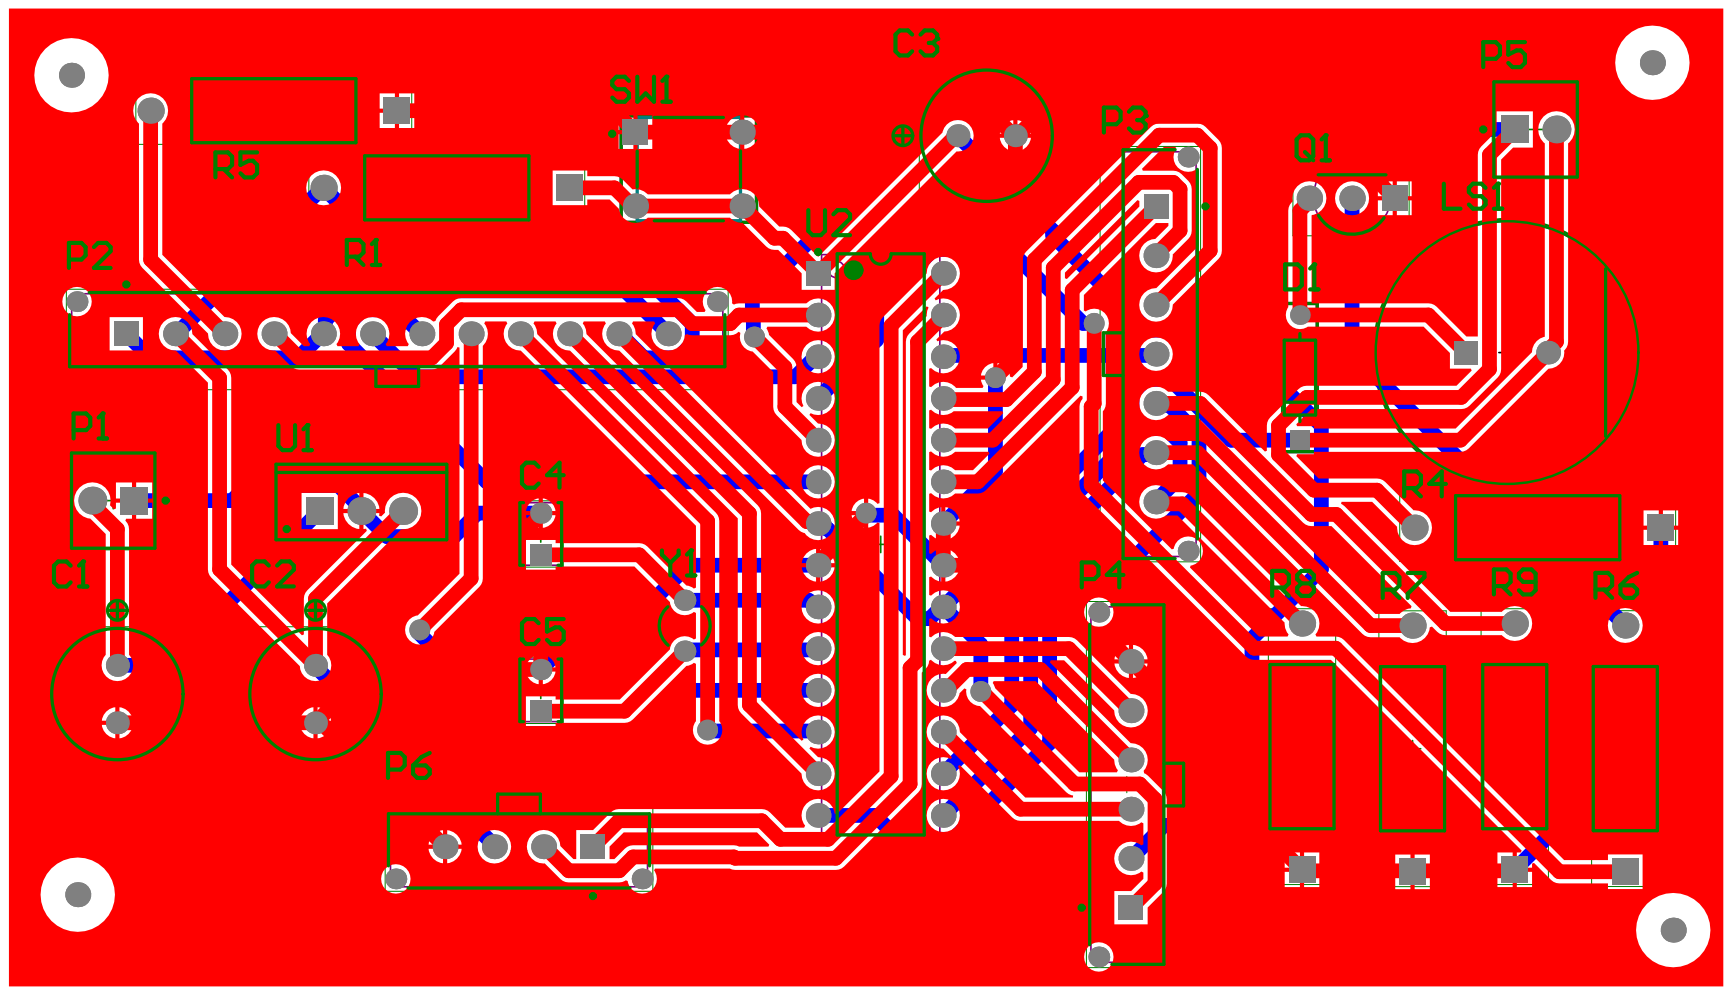
[picture p83: page 2]

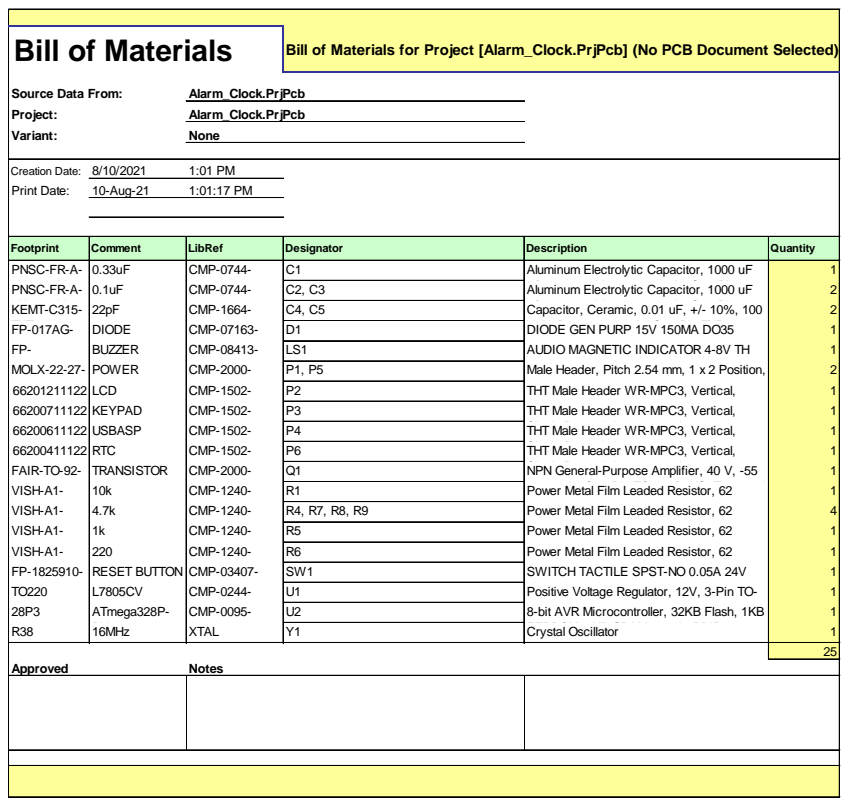
[picture p84: page 3]

Footprint | Comment | LibRef | Designator | Description | Quantity
