NuwanUdara/Digital-Alarm-Clock/Microproducts/Menu Display/Evaluation 2/PCB develop/schemtic/Schematic_Menu-display.pdf

## VCC POWER

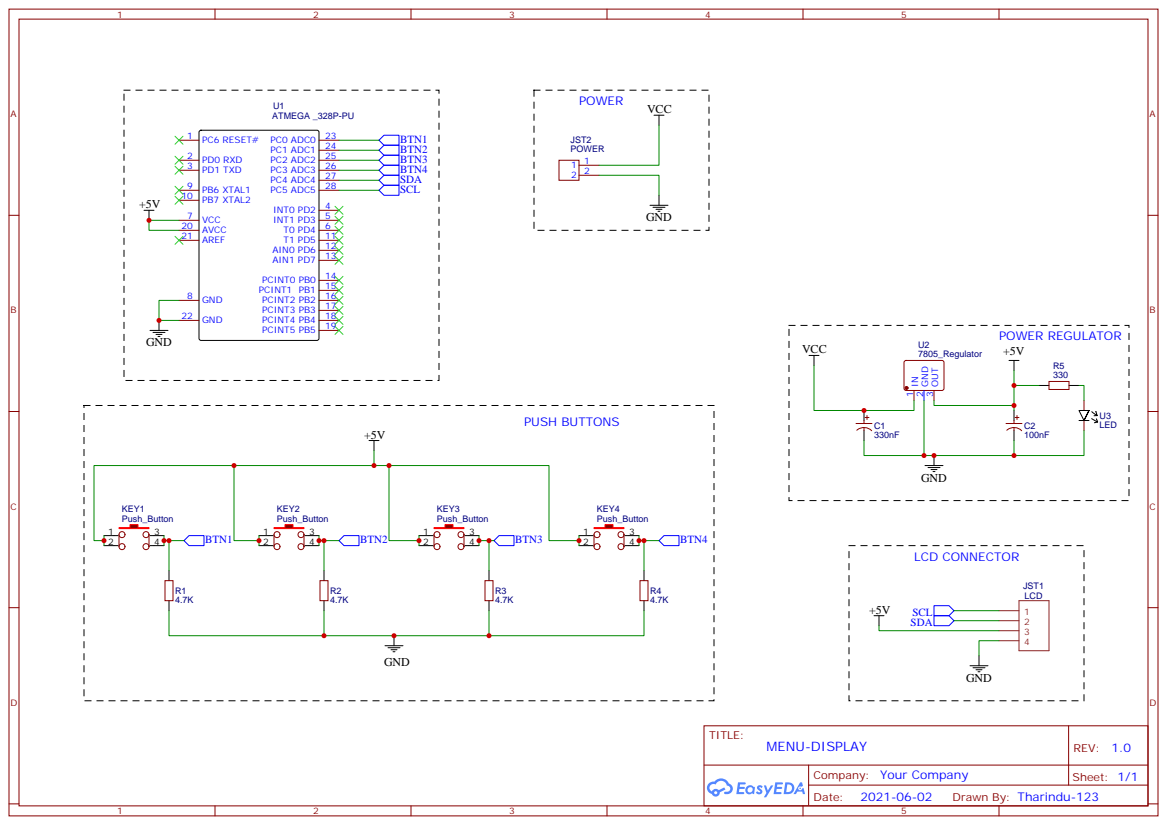
[picture p85: page 1]
