NuwanUdara/Digital-Alarm-Clock/Full Product/Report/src/Proteus.PDF

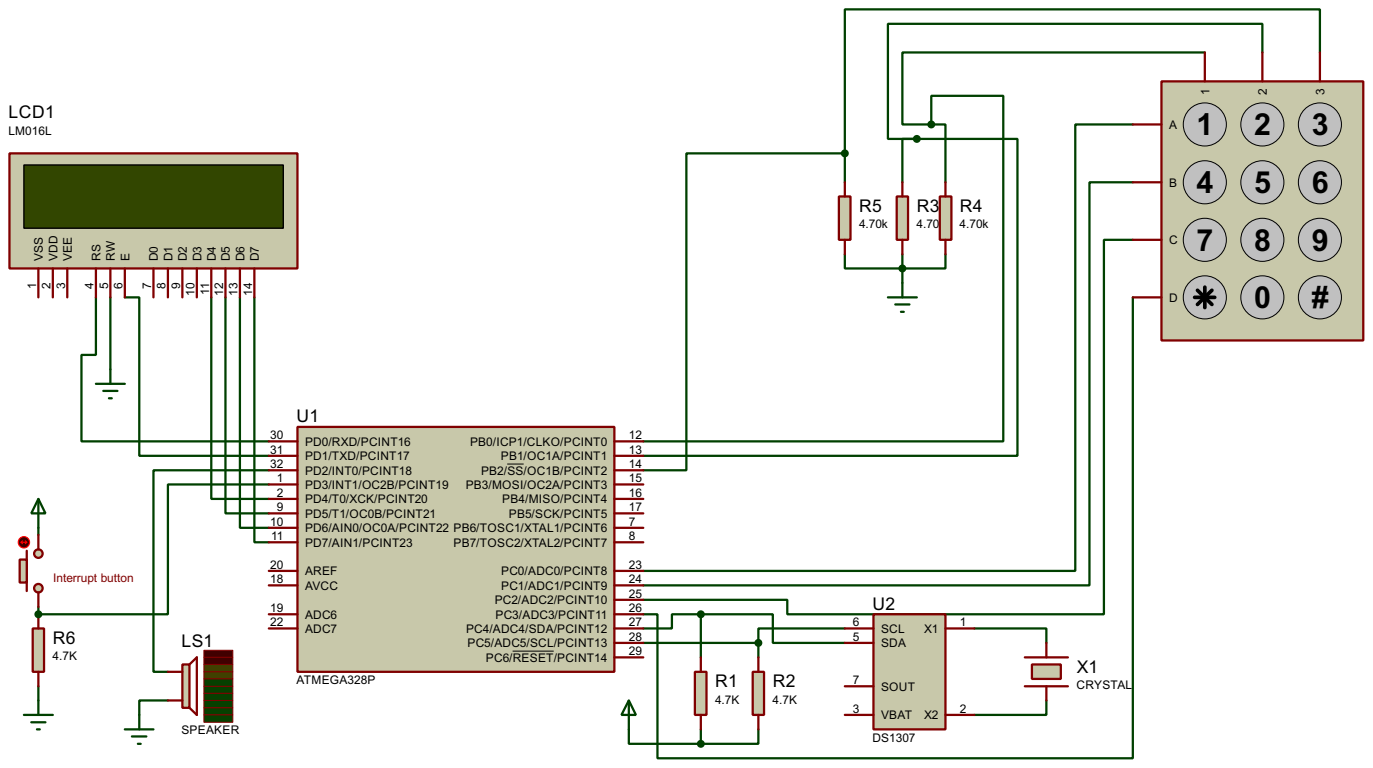
[picture p86: page 1]

D7 14 D6 13 D5 12 D4 11 D3 10 D2 9 D1 8 D0 7 E 6 RW 5 RS 4 VSS 1 VDD 2 VEE 3 LCD1 LM016L PB0/ICP1/CLKO/PCINT0 12 PB1/OC1A/PCINT1 13 PB3/MOSI/OC2A/PCINT3 15 PB2/SS/OC1B/PCINT2 14 PD6/AIN0/OC0A/PCINT22 10 PD5/T1/OC0B/PCINT21 9 PD4/T0/XCK/PCINT20 2 PD3/INT1/OC2B/PCINT19 1 PD2/INT0/PCINT18 32 PD1/TXD/PCINT17 31 PD0/RXD/PCINT16 30 PB4/MISO/PCINT4 16 PB5/SCK/PCINT5 17 PB7/TOSC2/XTAL2/PCINT7 8 PB6/TOSC1/XTAL1/PCINT6 7 PC6/RESET/PCINT14 29 PC5/ADC5/SCL/PCINT13 28 PC4/ADC4/SDA/PCINT12 27 PC3/ADC3/PCINT11 26 PC2/ADC2/PCINT10 25 PC1/ADC1/PCINT9 24 PC0/ADC0/PCINT8 23 AVCC 18 AREF 20 PD7/AIN1/PCINT23 11 ADC6 19 ADC7 22 U1 ATMEGA328P VBAT 3 X1 1 X2 2 SCL 6 SDA 5 SOUT 7 U2 DS1307 X1 R1 CRYSTAL 4.7K R2 4.7K 1 2 3 4 5 6 7 8 9 0 # 123 ABCD R3 4.70k R4 4.70k R5 4.70k R6 4.7K LS1 SPEAKER Interrupt button
