NuwanUdara/Digital-Alarm-Clock/Microproducts/Menu Display/Evaluation 2/PCB develop/Pcb/PCB_PCB_Menu-display.pdf

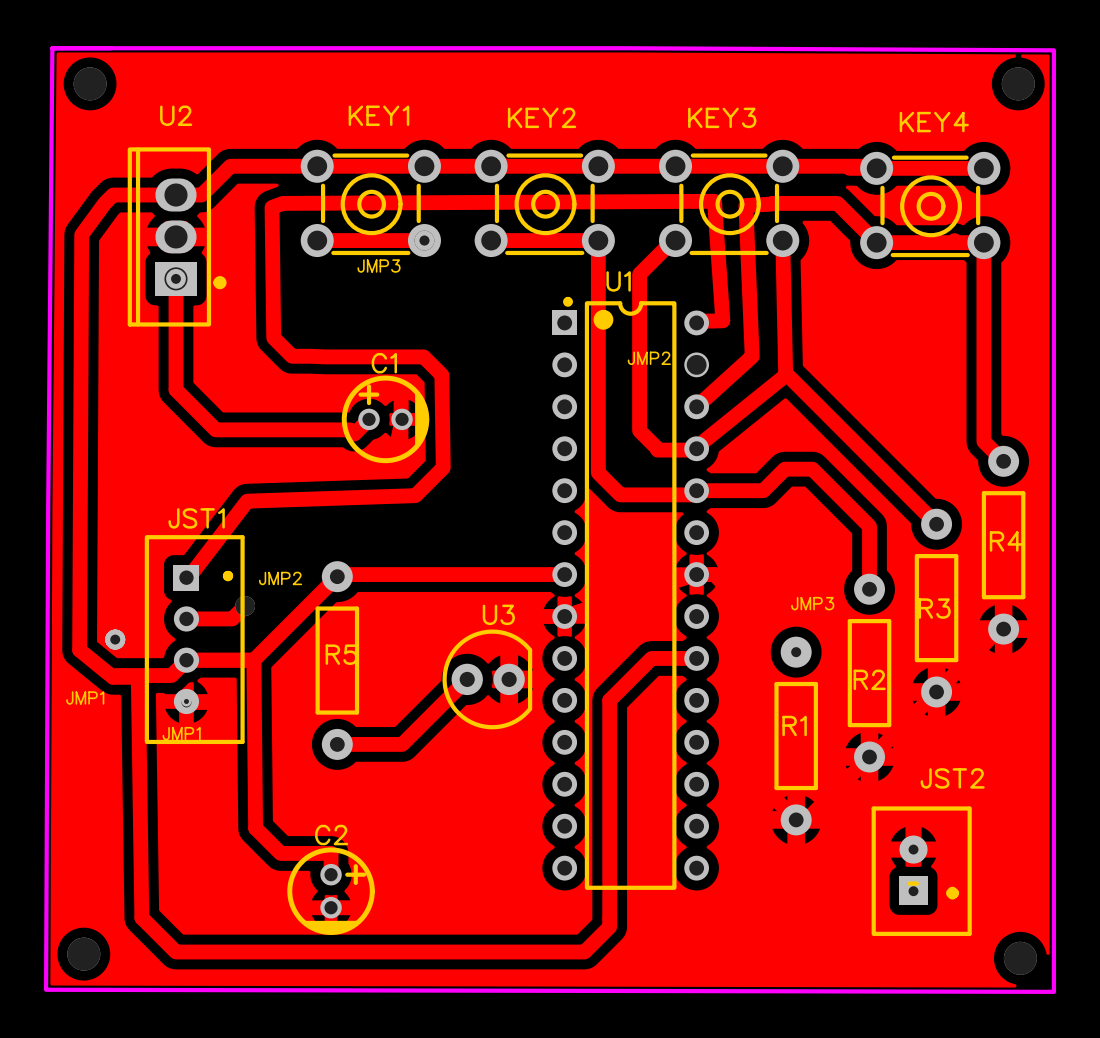
[picture p87: page 1]
