NuwanUdara/Digital-Alarm-Clock/Microproducts/Audio Ouput/PCB/PCB_PCB_Audio Output.pdf

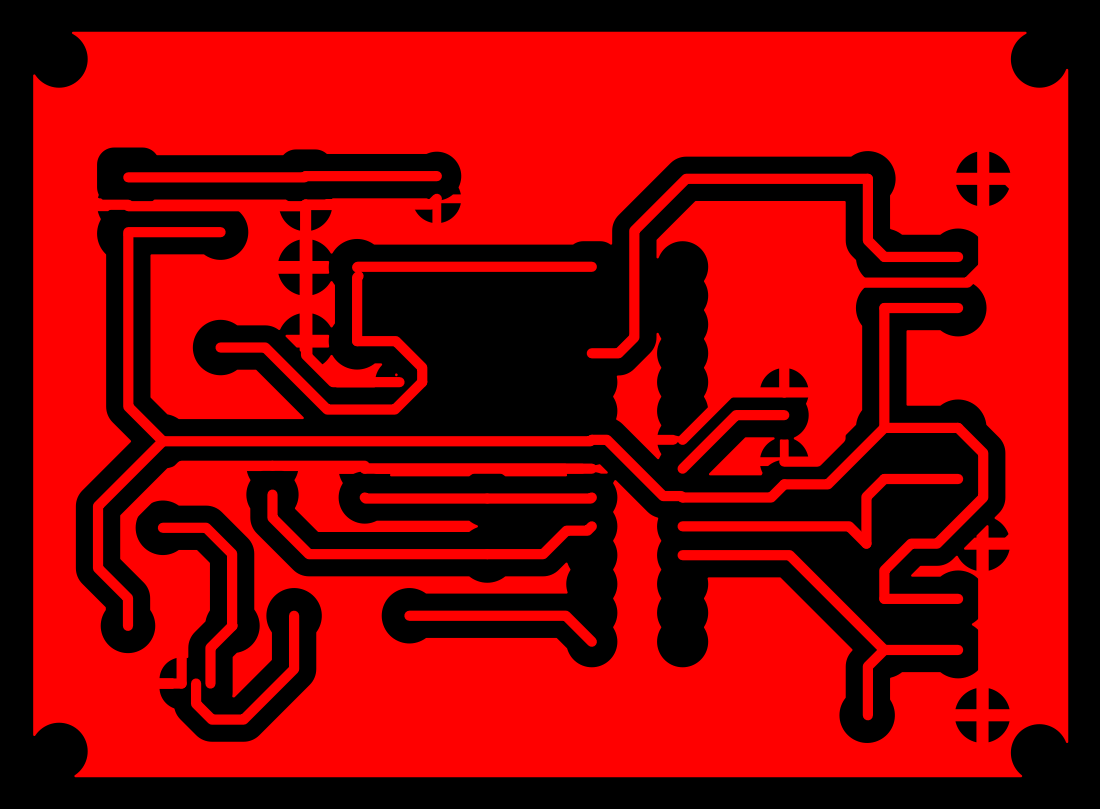
[picture p88: page 1]

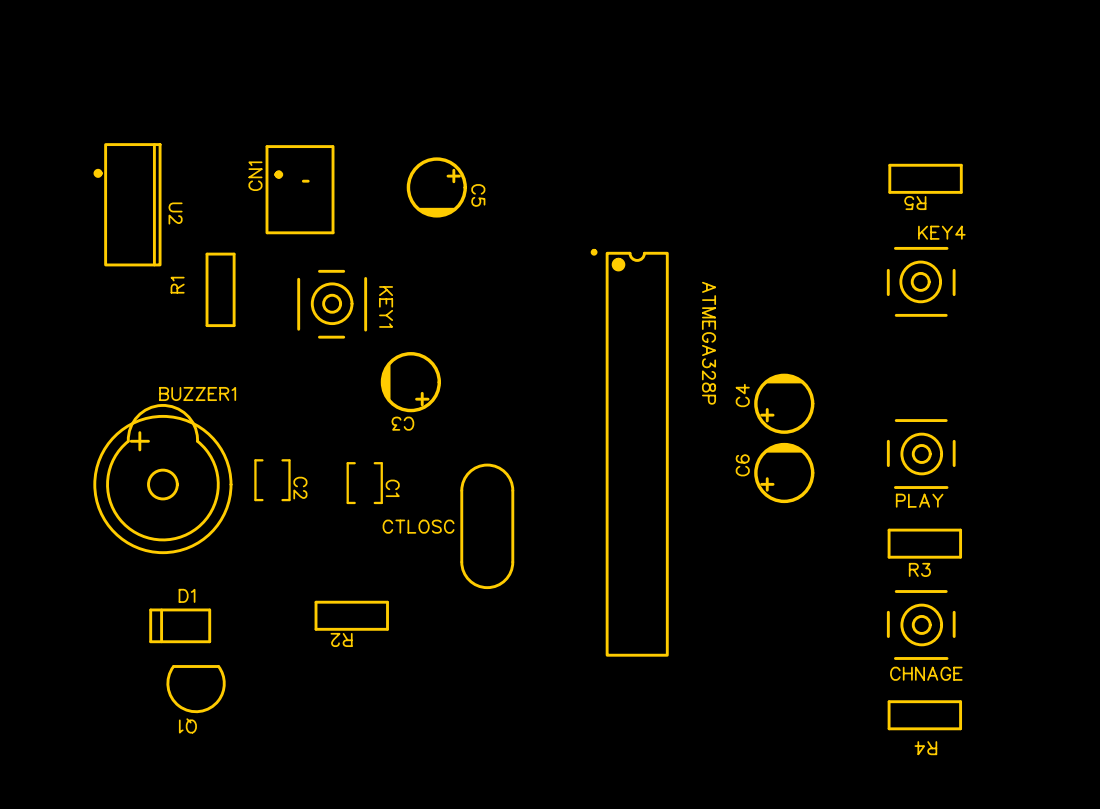
[picture p89: page 2]

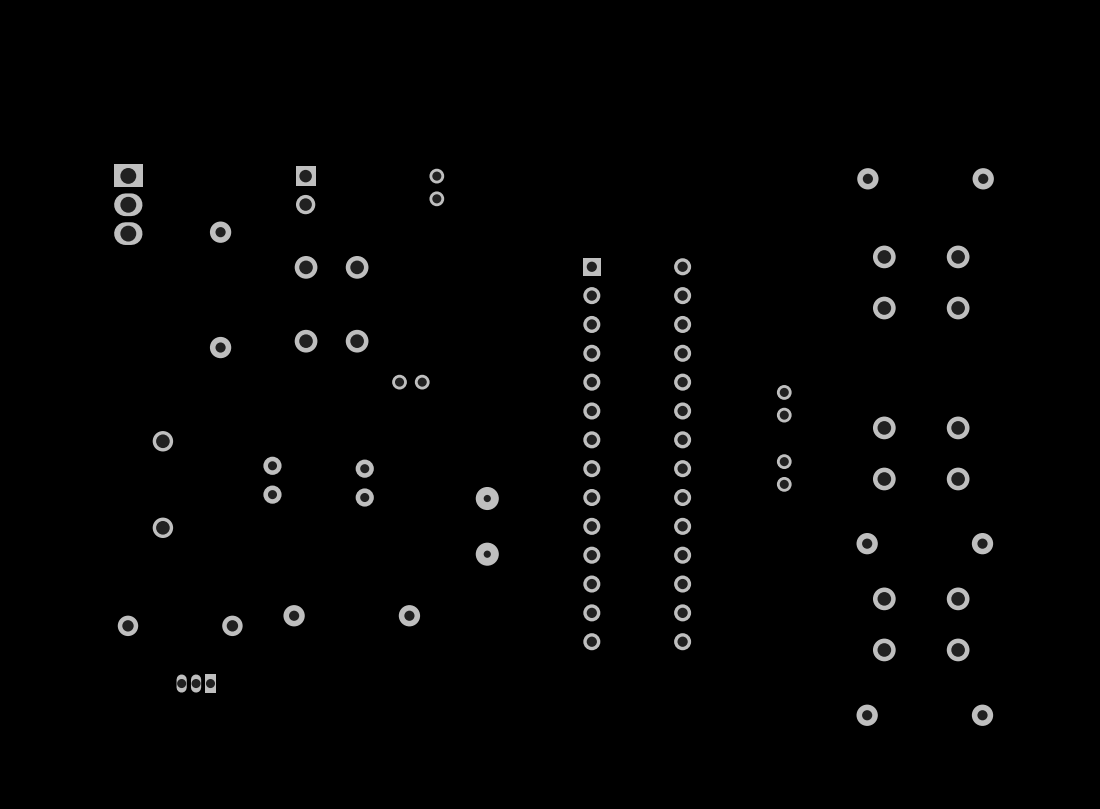
[picture p90: page 4]
