NuwanUdara/Digital-Alarm-Clock/Microproducts/Menu Display/PCB develop/Pcb/pcb menudisplay.pdf

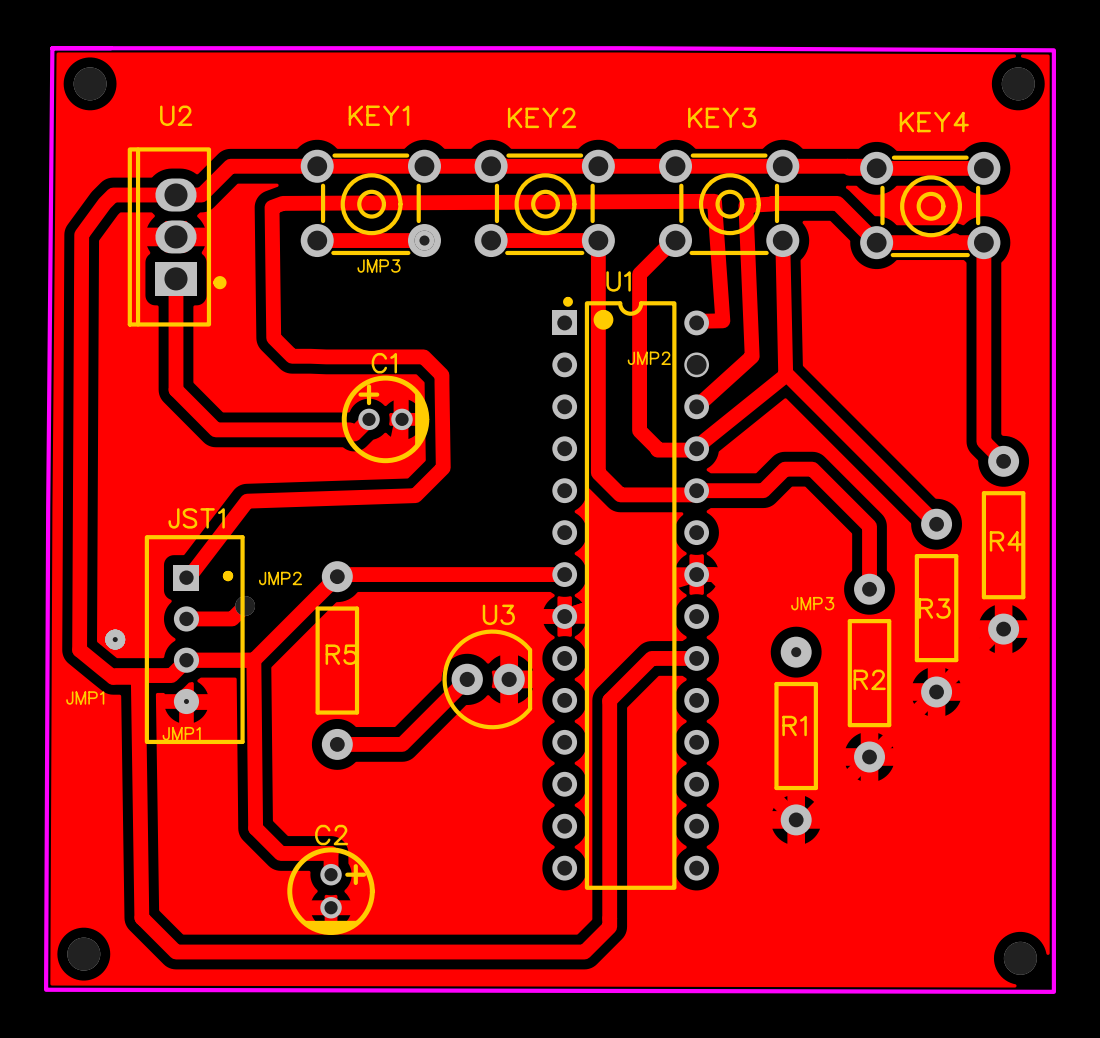
[picture p91: page 1]
