NuwanUdara/Digital-Alarm-Clock/(list of files, drawings)

Other design files:
Full Product/pcb_design/Alarm_Clock.PcbDoc
Full Product/pcb_design/Alarm_Clock.PrjPcb
Full Product/pcb_design/Alarm_Clock.SchDoc
Full Product/Simulation/Alarm Clock.pdsprj
Microproducts/Alarm Timing/Evaluation 2 - AVR/AVR_Simulation.pdsprj
Microproducts/Alarm Timing/PCB/Alarm TIming.PrjPcb
Microproducts/Alarm Timing/PCB/AlarmTiming.PcbDoc
Microproducts/Alarm Timing/PCB/AlarmTiming.SchDoc
Microproducts/Alarm Timing/Simulation/AlarmTiming.pdsprj
Microproducts/Audio Ouput/PCB/Audio Output.schdoc
Microproducts/Audio Ouput/PCB/PCB_Audio Output.pcbdoc
Microproducts/Audio Ouput/PCB/PCB_Audio Output_Dual_Layer.pcbdoc
Microproducts/Audio Ouput/PCB/PCB_Audio Output_Single_Layer.pcbdoc
Microproducts/Audio Ouput/PCB/PCB_Audio Output_Single_Layer_with_Jumpers.pcbdoc
Microproducts/Audio Ouput/simulation/Audio output.pdsprj
Microproducts/Audio Ouput/simulation/Audio_Output_AVR.pdsprj
Microproducts/Key Input/pcb_design/Key_Input/Key_Input.PcbDoc
Microproducts/Key Input/pcb_design/Key_Input/Key_Input.PrjPcb
Microproducts/Key Input/pcb_design/Key_Input/Key_Input.SchDoc
Microproducts/Key Input/pcb_design/keypad_library/keypad.PcbLib
Microproducts/Key Input/pcb_design/keypad_library/keypad.SchLib
Microproducts/Key Input/simulation/2-Evaluation/Key_Input.pdsprj
Microproducts/Key Input/simulation/2-Evaluation/Key_Input/Key_Input.pdsprj
Microproducts/Key Input/simulation/New Project.pdsprj
Microproducts/Menu Display/Evaluation 1/simulation/New Project.pdsprj
Microproducts/Menu Display/Evaluation 2/PCB develop/Pcb/PCB_Menu-display_2021-06-02.pcbdoc
Microproducts/Menu Display/Evaluation 2/PCB develop/schemtic/Menu-display schematic_2021-06-02.schdoc
Microproducts/Menu Display/Evaluation 2/simulation/LCD-display.pdsprj
