NuwanUdara/Digital-Alarm-Clock/Full Product/Report/src/AVR/main.cpp

#include <avr/io.h>			/* Include AVR std. library file */
#include <avr/interrupt.h>
#include "Display.h"
#include "ds1307.h"
#include "Alarm.h"
#include "Keypad.h"
#include "util/delay.h"
#include "Buzzer.h"
#define BUTTON_DELAY 500

#ifndef F_CPU
#define F_CPU 1000000UL
#endif
int main()
{
	init_buzzer();		// Initialize pins used for buzzer and Interrupt button
	LCD_Init();			/* Initialization of LCD*/
	LCD_String("   WELCOME!!!");
	_delay_ms(3000);
	ds1307_init();
	//int clocktime[6] = {21,05,4,12,8,35};
	//setClockTime(clocktime);
	//setAlarm(1209);setAlarm(1223);
	int menu = 0;
	char key;
	while(1){
		checkAlarm();
		key = btnPress();
		if (menu==0){
			displayTime();
		}
		if (key=='*'){
			_delay_ms(BUTTON_DELAY);
			menu ++;
			LCD_Clear();
		}
		if (menu>0){
			LCD_Menu(key,menu);
		}
		if (menu==3 | menu==-1){
			menu = 0;
			LCD_Clear();
		}
		if (key=='#'){
			_delay_ms(BUTTON_DELAY);
			menu --;
			LCD_Clear();
		}
	}
}
