NuwanUdara/Digital-Alarm-Clock/(commit log)

2021-03-30 add components
    [Alarm Timing.pdsprj]
2021-03-30 connect serial terminal with RTC and tested
    [AlarmTiming.pdsprj]
2021-03-30 take time from RTC and print it to serial terminal
2021-03-30 add set button and data buttom
2021-03-30 set alarm and light LED
2021-03-30 place 3 buttons and connected to arduino board
    [Alarm Timing.pdsprj, AlarmTiming.pdsprj]
2021-03-31 debugs some errors(alarm time and change time conflict)
    [sketch_mar30a.ino]
2021-03-31 change butttons name according to code
    [AlarmTiming.pdsprj]
2021-03-31 connect keypad with leds
    [New Project.pdsprj]
2021-03-31 code for testing the keypad with leds
2021-03-31 Button fixed and change nutton added
    [Audio output.pdsprj]
2021-04-01 This is a temp file by proteus and cannot be staged
2021-04-01 Changed the algorithem completely so the changes were not staged
2021-04-01 added another button to the main code to skip the song
    [Audio_output.ino]
2021-04-01 added the second song and fixed the bug
    [melodies.h]
2021-04-01 Modified for multiple song inputs.Still Need the 2nd button implimation
2021-04-01 added more leds
    [New Project.pdsprj]
2021-04-01 Added a 3rd button and fixed the order,Changed the UNO. No fatal bugs
    [Audio output.pdsprj]
2021-04-02 Made a patteren out of leds
    [New Project.pdsprj]
2021-04-02 changed the code for new circuit
2021-04-02 Added new buttons and change the code
    [New Project.pdsprj]
2021-05-10 add a i2c communicaion library
2021-05-10 add a led output and tested
2021-05-12 Create main code and blink one led
2021-05-12 add the microcontroller and one led and test it
    [Key_Input.pdsprj]
2021-05-12 add the keypad and one led
    [Key_Input.pdsprj]
2021-05-12 change the code to blink a led when press a key
2021-05-12 test the simulation with the code
    [Key_Input.pdsprj]
2021-05-12 change the code to blink leds as a seven segment
2021-05-12 add more leds and build the seven segment
    [Key_Input.pdsprj]
2021-05-12 check the simulation with the changed code
    [Key_Input.pdsprj]
2021-05-12 add 3 input buttons and tested
2021-05-13 proteues simulation
    [AVR_Simulation.pdsprj]
2021-05-15 add getAlarmTime() and powerOf() functions.
2021-05-16 updated schematic.
    [AVR_Simulation.pdsprj]
2021-05-16 proteues schematic
    [AVR_Simulation.pdsprj]
2021-05-17 change the main code to blink leds
2021-05-18 change the keypad function and test simulation
    [Key_Input.pdsprj]
2021-05-19 Evalution 1
    [New Project.pdsprj]
2021-05-19 test simulation for lcd display
    [LCD display.pdsprj]
2021-05-19 create a integrated library to create the keypad
    [keypad.SchLib]
2021-05-19 create the schematic of keypad
    [keypad.SchLib]
2021-05-19 create the pcb library file
    [keypad.PcbLib]
2021-05-19 create the holes of keypad
    [keypad.PcbLib]
2021-05-19 add the footprint to the schematic and compile
    [keypad.SchLib]
2021-05-19 change the schematic of the keypad
    [keypad.SchLib]
2021-05-19 create a pcb project to create the schematic
    [Key_Input.PrjPcb, Key_Input.SchDoc]
2021-05-19 add components to the schematic
    [Key_Input.SchDoc]
2021-05-19 create the schematic of the circuit
    [Key_Input.SchDoc]
2021-05-19 create the pcb file and import components
    [Key_Input.PcbDoc, Key_Input.PrjPcb]
2021-05-19 change the schematic
    [Key_Input.SchDoc]
2021-05-19 change the schematic and place the components
    [Key_Input.PcbDoc, Key_Input.SchDoc]
2021-05-20 align the leds in pcb layout
    [Key_Input.PcbDoc]
2021-05-20 routing components
    [Key_Input.PcbDoc]
2021-05-22 Added frequancy genarating method with CTC 16 bit clock, currentlyy not stable and contain bugs
    [main.cpp]
2021-05-23 Add pitch.h which contains notes and melodies.h which contains songs chords and durations
2021-05-23 Added 2nd method to genrate square waves. Its a stright forward method and stable, added pitch file and melodies file, fixed many comments and added function descriptions
    [main.cpp]
2021-05-26 Atmega328p proteus simulation files
    [Audio_Output_AVR.pdsprj]
2021-05-26 change the schematic of keypad library
    [keypad.SchLib]
2021-05-26 change the keypad of the schematic
    [Key_Input.SchDoc, keypad.SchLib]
2021-05-27 add reset button
    [AVR_Simulation.pdsprj]
2021-05-30 add new button
2021-05-30 add new button for microcontroller
    [LCD display.pdsprj, LCD-display.pdsprj]
2021-05-31 Added interrupt button and other 2 buttons to play, chnage and stop. Stable
2021-05-31 PCB design done with eazyEDA
    [Audio Output.schdoc, PCB_Audio Output_Dual_Layer.pcbdoc, PCB_Audio Output_Single_Layer.pcbdoc, PCB_Audio Output_Single_Layer_with_Jumpers.pcbdoc]
2021-05-31 change the pcb file
    [Key_Input.PcbDoc]
2021-05-31 add enter button
    [LCD-display.pdsprj]
2021-06-01 add new button and sub menus
2021-06-01 add new button to microcontaller
    [LCD-display.pdsprj]
2021-06-01 PCB Schematic
    [AlarmTiming.PcbDoc]
2021-06-01 PCB Layout
    [AlarmTiming.PcbDoc]
2021-06-01 add four buttons and create all sub menus
2021-06-01 add four buttons
    [LCD-display.pdsprj]
2021-06-01 updated pcb files with better clearance on copper region and improved routes.
    [PCB_Audio Output_Dual_Layer.pcbdoc, PCB_Audio Output_Single_Layer.pcbdoc, PCB_Audio Output_Single_Layer_with_Jumpers.pcbdoc]
2021-06-01 New design. The single layer pcb with better routing. Final PCB
    [PCB_Audio Output.pcbdoc]
2021-06-02 add Pcb .pngfile
2021-06-02 add PCB pdf file
2021-06-02 add PCB .json file
2021-06-02 add schematic .json file
2021-06-02 add schematic .png file
2021-06-02 Solidworks Enclosure
    [Enclosure.SLDASM, LED.SLDPRT, Led_Verde.SLDPRT, PCB.step, Push Button.SLDPRT]
2021-06-02 Schematic Document
    [AlarmTiming.SchDoc]
2021-06-02 Add Schematic and PCB
    [Alarm TIming.PrjPcb, AlarmTiming.PcbDoc, AlarmTiming.SchDoc]
2021-06-02 add power port
2021-06-02 add Altium flie which get from EasyEDA
    [Menu-display schematic_2021-06-02.schdoc, PCB_Menu-display_2021-06-02.pcbdoc]
2021-06-03 change the schematic and pcb
    [Key_Input.PcbDoc, Key_Input.SchDoc]
2021-06-04 Enclosure design
    [Key_Input.SLDASM, Key_Input.step, keypad.SLDPRT, led.SLDPRT, led2.SLDPRT, led_full.SLDASM, switch.SLDPRT]
2021-06-05 Initial Enclosure Design without buttons
    [Assem4.SLDASM, Assem5.SLDASM, Assem6.SLDASM, PCB_Audio Output.step.SLDASM, Part7^PCB_Audio Output.step.SLDPRT, Part8^PCB_Audio Output.step. v1SLDPRT.SLDPRT]
2021-06-05 add all sub parts of enclosure
    [LCD.SLDASM, Menu-display schematic_2021-06-02.schdoc, New Project.pdsprj, OBJ_PCB_Menu-display.SLDPRT, PCB_Menu-display_2021-06-02.pcbdoc, back cover.SLDPRT, face.SLDPRT, nut.SLDPRT]
2021-06-05 add initial full enclosure
    [full product.SLDASM]
2021-06-07 Added buttons and fixed mates, Added texts, Final build
    [Assem7.SLDASM, Button.SLDPRT, Open CASCADE STEP translator 6.8 1.1.1.step.SLDPRT, PCB_Audio Output.step, Part7^PCB_Audio Output.step.SLDPRT, Part8^PCB_Audio Output.step. v1SLDPRT.SLDPRT]
2021-06-09 modify enclosure
    [full product.SLDASM]
2021-06-14 Added full product simulation file.
    [Alarm Clock.pdsprj]
2021-06-14 change the delay time of buttons
2021-06-14 Added a speaker and a button to the simulation
    [Alarm Clock.pdsprj]
2021-06-14 Added Buzzer files to the main code
    [main.cpp]
2021-06-14 added set tone menu and checked
    [Alarm Clock.pdsprj]
2021-06-15 added blinking function to set alarm menu.
    [Alarm Clock.pdsprj]
2021-06-16 change inturupt button to INT1
2021-06-17 changed the ports of the keypad and checked.
    [Alarm Clock.pdsprj]
2021-06-17 added blinking feature to set date menu.
    [Alarm Clock.pdsprj]
2021-06-17 added the set tone feature for each alarm.
    [Alarm Clock.pdsprj]
2021-06-19 schematic and pcb of the full product
    [Alarm_Clock.PcbDoc, Alarm_Clock.PrjPcb, Alarm_Clock.SchDoc]
2021-08-09 added delete alarms features.
    [Alarm_Clock.GBL, Alarm_Clock.GBO, Alarm_Clock.GBS, Alarm_Clock.GKO, Alarm_Clock.GM1, Alarm_Clock.GTL, Alarm_Clock.GTO, Alarm_Clock.GTS]
2021-08-09 added countdown timer feature.
2021-08-09 fixed some bugs and tested.
    [Alarm.cpp, Alarm.h, Display.cpp, main.cpp]
2021-08-09 add initial sketch of enclosure
    [E-Stop_Assembled.SLDASM, full product.SLDASM]
2021-08-09 add components of final
    [Emergency Stop Button.SLDPRT, STP310400160.SLDPRT, cover.SLDPRT, leg.SLDPRT, pin1 lcd.SLDPRT]
2021-08-09 add final enclosure
2021-08-10 fixed interrupt bug.
2021-08-11 add all component
    [16pin_header__.sldprt, 9V Battery Holder.SLDPRT, Alarm_Clock.step, Battery.SLDPRT, KeyPad_3x4_w_pcb.SLDASM, KeyPad_3x4_w_pcb.step, LCD.SLDASM, backlight.SLDPRT]
